etphli/ist-pico-project/cad/viewer/evidence/main-desktop-quarter.png

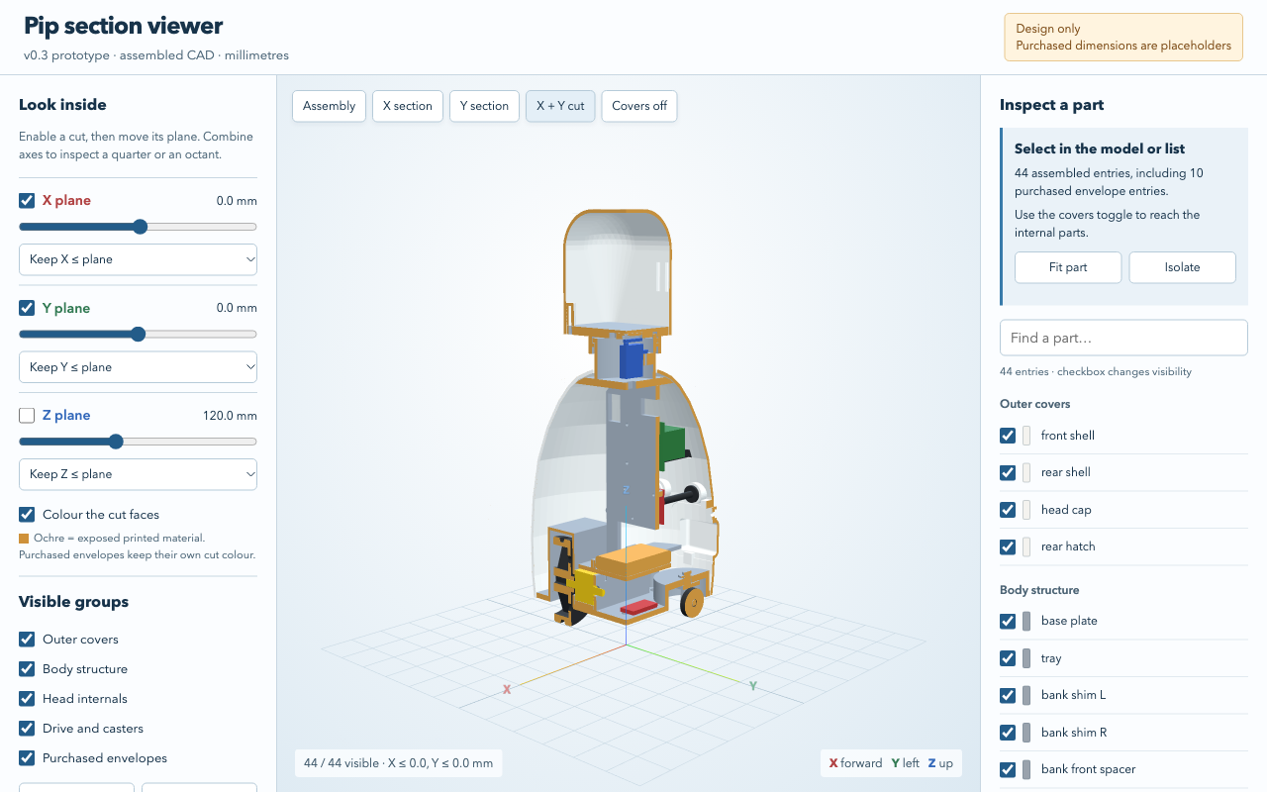
cad/viewer/evidence/main-desktop-quarter.png
