etphli/ist-pico-project/cad/viewer/evidence/main-mobile.png

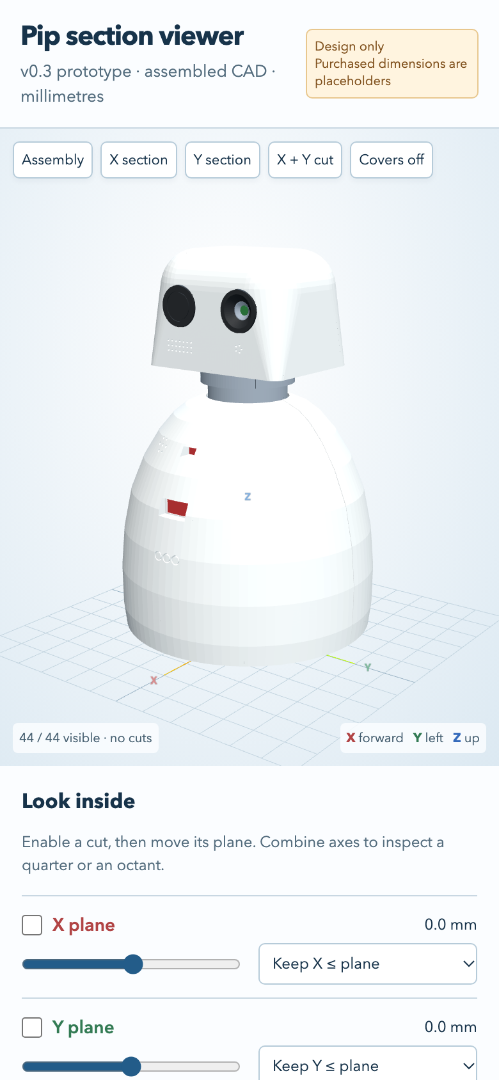
cad/viewer/evidence/main-mobile.png
