etphli/ist-pico-project/cad/viewer/evidence/quarter-cut.png

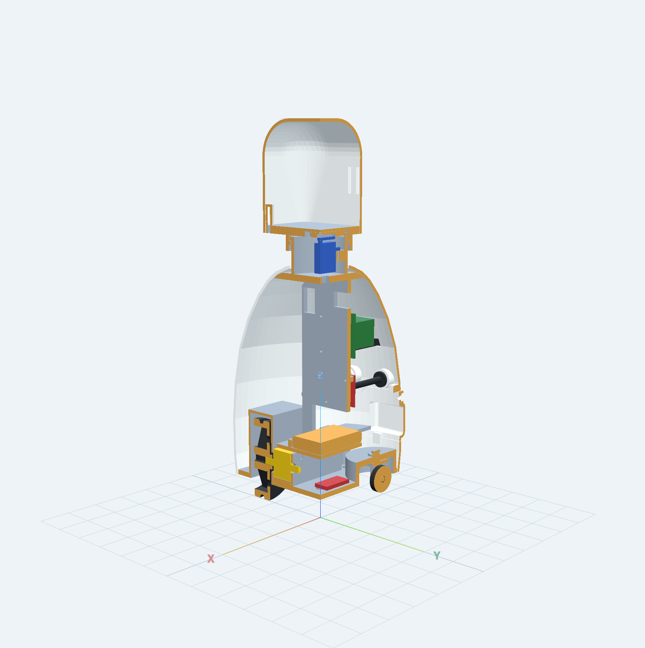
cad/viewer/evidence/quarter-cut.png
