etphli/ist-pico-project/docs/bom.csv

id | option | item | supplier | sku | qty | unit_aud_inc_gst | ext_aud_inc_gst | price_status | stock_2026-10-19 | role | requirement | solder_free_note | url
B1 | full;R1 | Kitronik Compact Motor Driver Board for Raspberry Pi Pico (5331; DRV8833) | Core Electronics | CE07855 | 1 | 19.95 | 19.95 | live product page 2026-10-19 | in stock (3 today; more 8-10 days) | 2-channel motor drive with stated short-circuit/over-current/thermal protection; on/off switch; powers Pico | F1 F2 F6 | Pico 2 WH plugs into socket; screw terminals | https://core-electronics.com.au/kitronik-motor-driver-board-for-raspberry-pi-pico.html
B2 | full;R1 | DC Gearbox TT Motor 200RPM 3-6V (200 mm 28 AWG leads with male pins) | Core Electronics | ADA3777 | 2 | 7.35 | 14.70 | live product page 2026-10-19 | in stock | drive wheels | F2 | leads pre-attached; pins clamp in screw terminals | https://core-electronics.com.au/dc-gearbox-motor-tt-motor-200rpm-3-to-6vdc.html
B3 | full;R1;R2 | Feetech FS90 9g micro servo 4.8-6V | Core Electronics | CE09376 | 1 | 5.70 | 5.70 | live product page 2026-10-19 | in stock | head pan | F3 | FS90 plug; rated compatible preterminated harness required (B20); actual pinout to verify | https://core-electronics.com.au/feetech-fs90-1-5kgcm-micro-servo-9g.html
B4 | full;R2 | DFRobot ESP32-S3 AI Camera Module DFR1154 (OV3660 160 deg; PDM mic; MAX98357 amp; MX1.25 speaker socket); manufacturer package includes speaker | Core Electronics | DFR1154 | 1 | 37.23 | 37.23 | live product page 2026-10-19; package list corrected 2026-10-21; confirm retailer bundle | in stock (16 today) | camera + mic + speaker amp in head | F5 F8 F9 | USB-C power; speaker plug-in | https://core-electronics.com.au/esp32-s3-ai-camera-module-edge-image-recognition-night-vision-voice-interaction.html
B5 | optional-spare | Mini Oval Speaker 8 ohm 1 W (Molex PicoBlade 1.25 mm 2-pin plug) | Core Electronics | ADA3923 | 0 | 4.80 | 0.00 | optional spare only; manufacturer DFR1154 package includes speaker; verify retailer bundle | OUT OF STOCK | not required when supplied speaker is present; previous duplicate purchase removed | F9 | plug-in if connector matches DFR1154 MX1.25 (to confirm) | https://core-electronics.com.au/mini-oval-speaker-8-ohm-1-watt.html
B6 | full;R1;R2 | PiicoDev Button | Core Electronics | CE08500 | 2 | 8.05 | 16.10 | live product page 2026-10-19 | in stock | rear button A wake + rear button B movement enable (I2C) | F6 | PiicoDev cable; A all ID OFF 0x42; B ID1 ON 0x09; power-cycle after setting | https://core-electronics.com.au/piicodev-button.html
B7 | full;R1 | PiicoDev Prototyping Cable (Male) 200mm | Core Electronics | CE07796 | 1 | 0.95 | 0.95 | live catalogue search 2026-10-19 | not shown | I2C chain from Kitronik GPIO terminals | F7 | SH-to-male breakout; terminal clamp fit and bus interface must be verified; not covered by owned SH-to-SH stock | https://core-electronics.com.au/piicodev-breakout-cable-200mm.html
B8 | full | USB-A male plug to 5-pin screw terminal block | Core Electronics | ADA3628 | 1 | 9.65 | 9.65 | live product page 2026-10-19 | in stock | bank port 1 -> body 5 V feed | F4 | no soldering (Core) | https://core-electronics.com.au/usb-a-male-plug-to-5-pin-terminal-block.html
B9 | full;R1 | Wago 221-413 3-conductor lever connector | Core Electronics | WG-221-413 | 2 | 1.40 | 2.80 | live catalogue search 2026-10-19 | in stock | +5 V / GND split to controller and servo | F4 | lever clamp (check wire gauge range on Wago data) | https://core-electronics.com.au/search/wago
B10 | full;R1 | Jumper Wire 10cm Ribbon M/M 40pcs | Core Electronics | CE09607 | 1 | 3.20 | 3.20 | live catalogue search 2026-10-19 | not shown | provisional signal wiring only; delete from order if B20 supplies signal lead | F3 | not approved for servo power or Wago termination without verified gauge and rating | https://core-electronics.com.au/search/jumper%20wire
B11 | full;R2 | USB-A to USB-C Cable 50cm 2A | Core Electronics | CE09370 | 1 | 3.25 | 3.25 | live product page 2026-10-19 | in stock | bank port 2 -> camera switch | F5 F15 | plug-in | https://core-electronics.com.au/50cm-usb-a-usb-c-cable.html
B12 | full;R2 | USB-C In-Line Power Switch Cable 28 cm (C female -> C male; power pins only; <=3 A) | Core Electronics | CE06575 | 1 | 3.45 | 3.45 | live product page 2026-10-19 | in stock | camera/mic hard-off | F15 | plug-in | https://core-electronics.com.au/micro-usb-c-in-line-power-switch-cable-for-raspberry-pi-4.html
B13 | full;R1;R2 | Delivery (Core standard) | Core Electronics | - | 1 |  |  | not quoted for this cart; example quote AU$6.25 to postcode 2000 for smaller carts | - | delivery | F11 | -
B14 | full | Stranded wire ~22 AWG red + black; measure W2-W5 routes | - | - | 1 |  |  | unpriced; no cheaper verified short pack found | - | 5 V feed ADA3628 -> lever connectors -> Kitronik; all W2-W5 lengths | F4 | 11 mm strip at Wago 221-413 ends; other terminal ends to their own marked requirement
B15 | full;R1;R2 | MINISO QW01 10000mAh power bank; approx 130x60x10mm; micro-USB input; two USB-A outputs each user-reported 5V 2A | - | QW01 | 1 | 0 | 0 | owned; user report 2026-10-20; combined output and fit unverified | owned | battery + accessible charge port | F4 | finished product
B16 | full;R1;R2 | Screws: 15 x M3 total (6 x M3x10; 5 x M3x8; 4 x M3x12); 4 x M2.5x6 | - | - | 1 |  |  | unpriced | - | frame/shell/head/board/button retention | N7 N10 | -
B17 | full;R1;R2 | 2 x hook-and-loop strap approx 12x250mm (bank); 2 x O-ring approx 60mm ID (tyres) | - | - | 1 |  |  | unpriced; maybe owned | - | retention; traction | F2 F4 | -
B18 | full;R1;R2 | FS90 mounting-tab and horn hardware; verify supplied screws and measure sizes | - | - | 1 |  |  | unpriced; sizes and supplied contents unverified |  | servo retention; additional to 15 x M3 fasteners | F3 N7 N10 | mechanical fasteners
B19 | full;R1 | PiicoDev direct-wiring interface and aggregate pull-up arrangement; solder-free implementation unselected | - | - | 1 |  |  | unpriced; unselected |  | sensor bus signal conditioning and cable-load review | F3 F7 | no soldering; verify compatibility
B20 | full;R1 | Rated preterminated FS90-compatible servo power harness; exact part unselected | - | - | 1 |  |  | unpriced; unselected |  | servo V+ and GND; may also provide GP27 signal lead | F3 F7 | no soldering; verify compatibility
O1 | full;R1;R2 | Standard PiicoDev SH-to-SH module cables; unlimited owned stock | - | - | 9 | 0.00 | 0.00 | owned; user confirmation 2026-10-21 |  | nine planned inter-module links C1-C9 | F7 | no soldering; verify compatibility
X1 | rejected | Makerverse Motor Driver 2 Channel | Core Electronics | CE08038 | 1 | 6.60 | 6.60 | live product page 2026-10-19 | in stock | rejected: terminals/headers need soldering (Core guide: unsoldered pads) | - | - | https://core-electronics.com.au/makerverse-motor-driver-2-channel.html
X2 | rejected | TT Motor 50RPM L-type (JST-PH) | Core Electronics | CE09390 | 2 | 2.50 | 5.00 | live product page 2026-10-19 | in stock | rejected: rated 3 V | - | - | https://core-electronics.com.au/tt-motor-l-type-50-rpm.html
X3 | rejected | Cytron Robo Pico | Core Electronics | CE11203 | 1 | 27.90 | 27.90 | live product page 2026-10-19 | OUT OF STOCK | rejected: out of stock; 1 A continuous < TT stall; no driver protection stated | - | - | https://core-electronics.com.au/robo-pico-simplifying-robotics-with-raspberry-pi-pico-pico-w.html
X4 | rejected | Battery Bank 5000mAh (one 5 V 2.1 A output) | Core Electronics | AD0505B | 1 | 26.95 | 26.95 | live product page 2026-10-19 | in stock | rejected for full concept: single output; price | - | - | https://core-electronics.com.au/battery-bank-5000mah.html
