etphli/ist-pico-project/cad/out/assembly_preview.stl

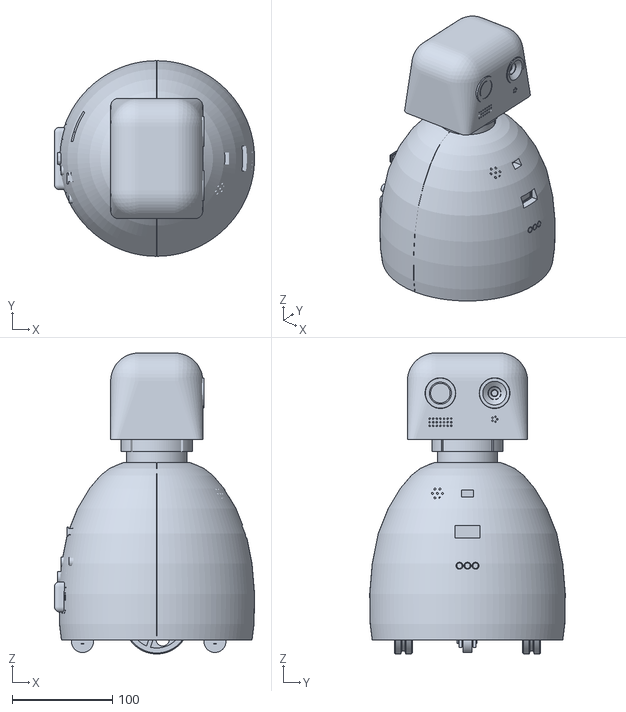
[picture p5: CAD file, 2026-10-21]
cad/out/assembly_preview.stl
199.5 x 195.0 x 300.0
