etphli/ist-pico-project/cad/out/stl/rear_hatch.stl

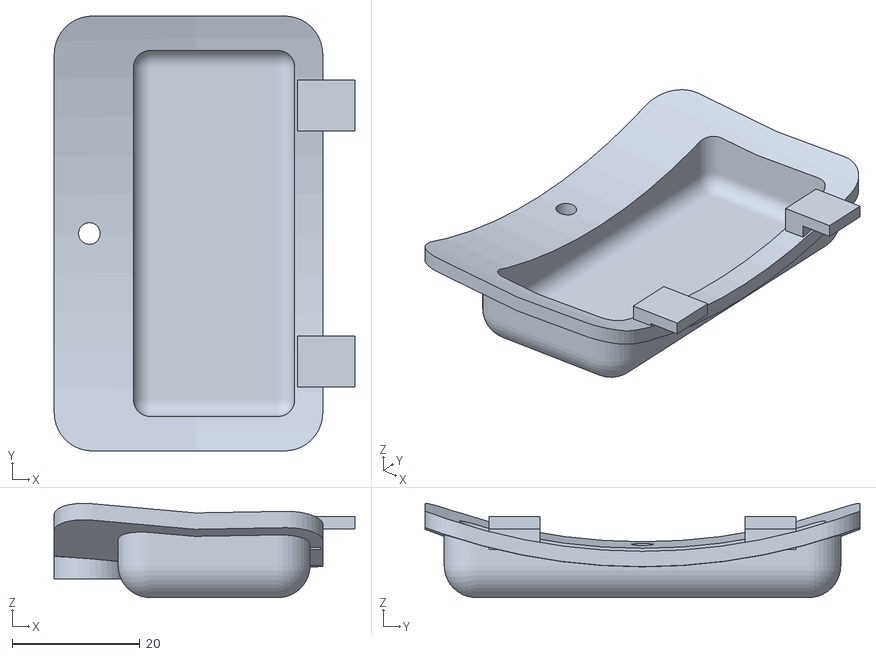
[picture p6: CAD file, 2026-10-21]
cad/out/stl/rear_hatch.stl
47.0 x 68.0 x 14.7
