etphli/ist-pico-project/cad/out/stl/base_plate.stl

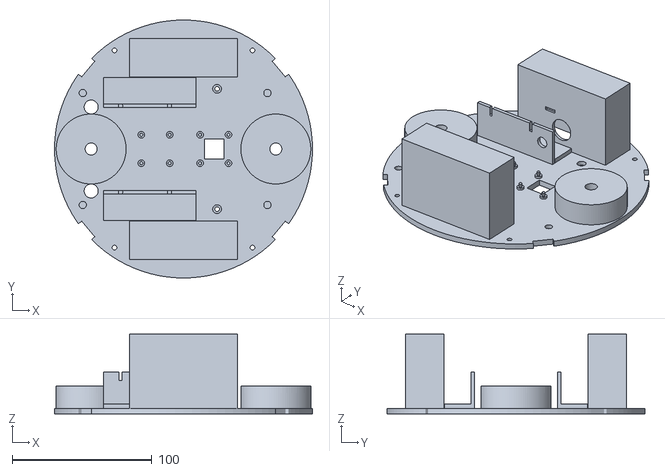
[picture p7: CAD file, 2026-10-21]
cad/out/stl/base_plate.stl
184.4 x 184.4 x 57.0
