etphli/ist-pico-project/cad/out/stl/bank_front_spacer.stl

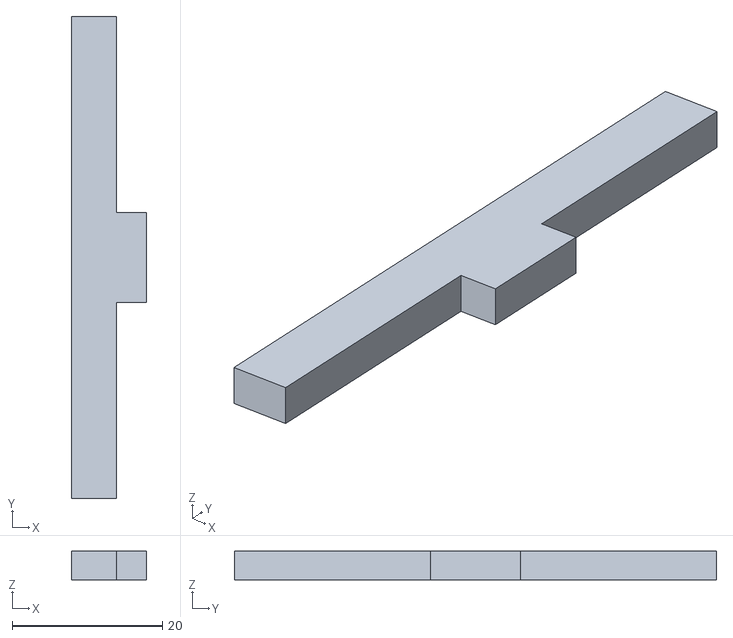
[picture p8: CAD file, 2026-10-21]
cad/out/stl/bank_front_spacer.stl
10.0 x 64.2 x 3.80
