etphli/ist-pico-project/cad/out/stl/column_L.stl

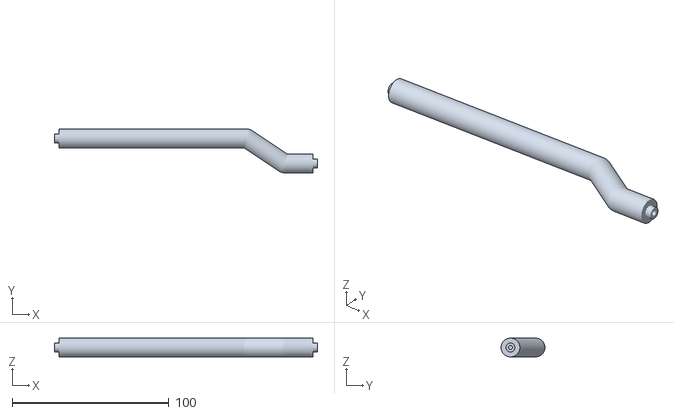
[picture p9: CAD file, 2026-10-21]
cad/out/stl/column_L.stl
167.8 x 28.0 x 12.0
