etphli/ist-pico-project/cad/out/stl/tray.stl

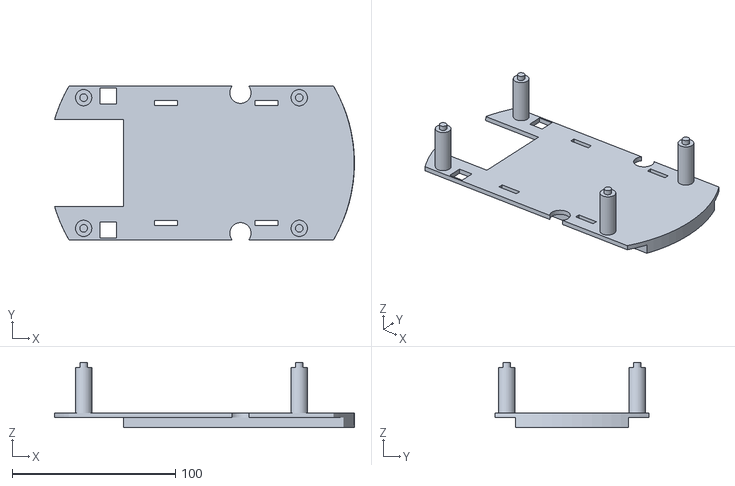
[picture p10: CAD file, 2026-10-21]
cad/out/stl/tray.stl
183.7 x 94.0 x 39.8
