etphli/ist-pico-project/cad/out/stl/bank_shim_R.stl

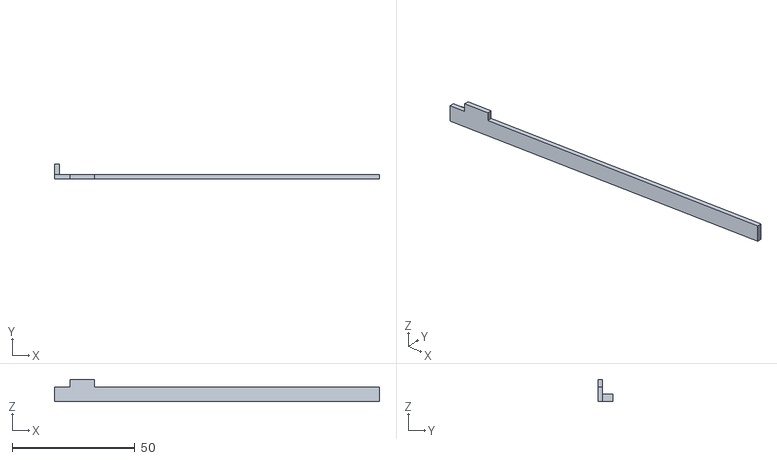
[picture p11: CAD file, 2026-10-21]
cad/out/stl/bank_shim_R.stl
132.3 x 6.10 x 9.00
