etphli/ist-pico-project/cad/out/stl/rear_shell.stl

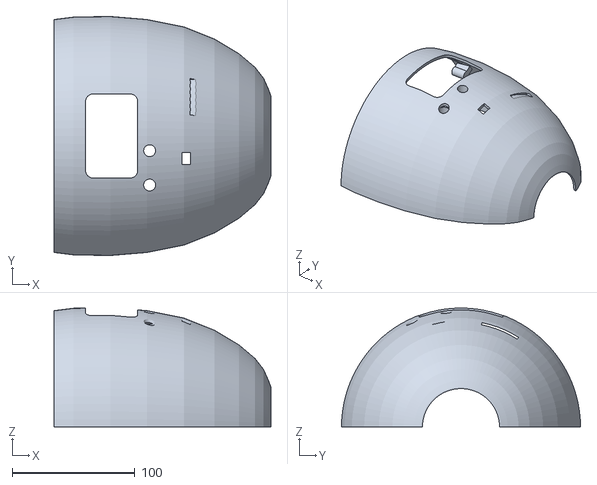
[picture p12: CAD file, 2026-10-21]
cad/out/stl/rear_shell.stl
177.0 x 195.0 x 97.0
