etphli/ist-pico-project/cad/out/stl/head_base.stl

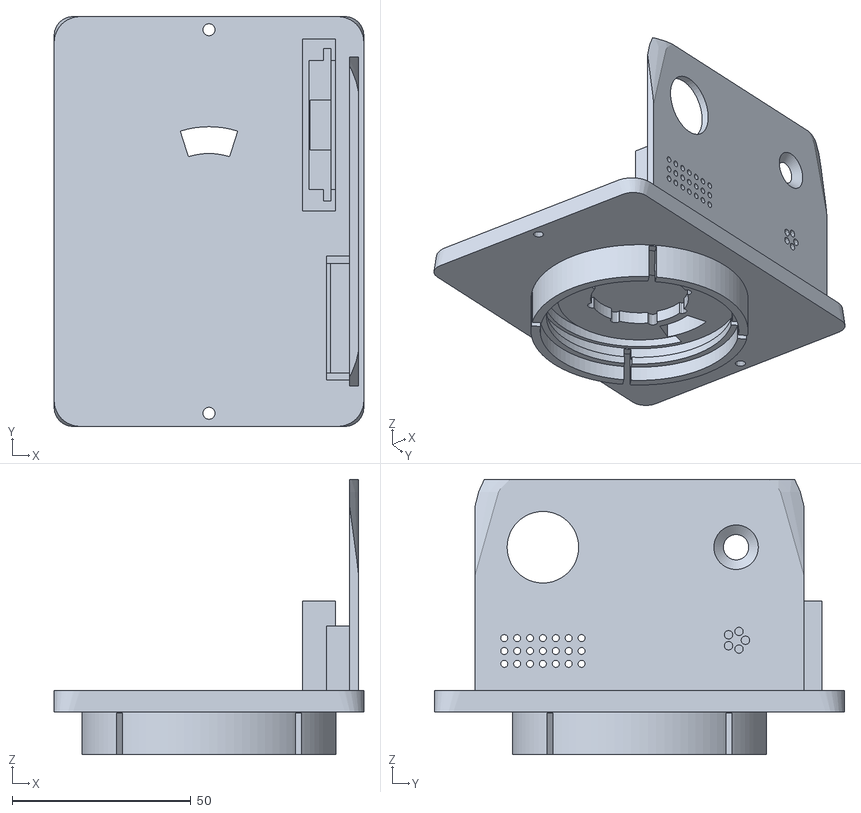
[picture p13: CAD file, 2026-10-19]
cad/out/stl/head_base.stl
86.6 x 114.6 x 77.0
