etphli/ist-pico-project/cad/out/stl/plunger_move.stl

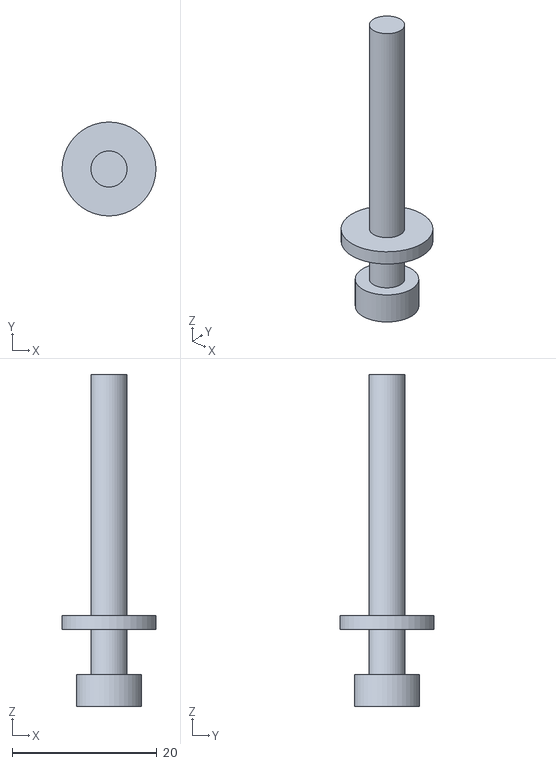
[picture p14: CAD file, 2026-10-19]
cad/out/stl/plunger_move.stl
13.0 x 13.0 x 45.9
