etphli/ist-pico-project/cad/out/stl/top_deck.stl

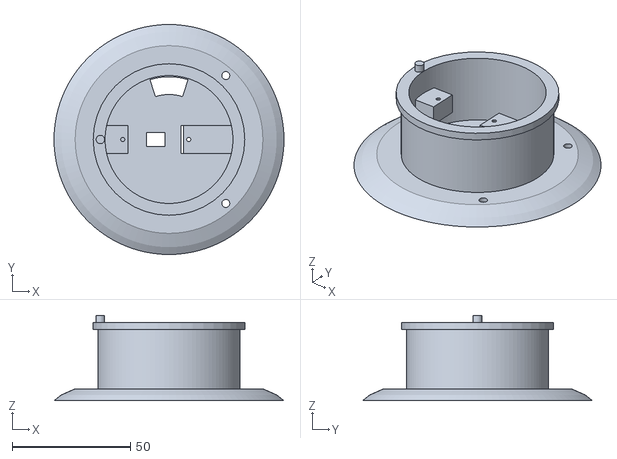
[picture p15: CAD file, 2026-10-19]
cad/out/stl/top_deck.stl
97.1 x 97.1 x 36.0
