etphli/ist-pico-project/cad/out/stl/rear_upright.stl

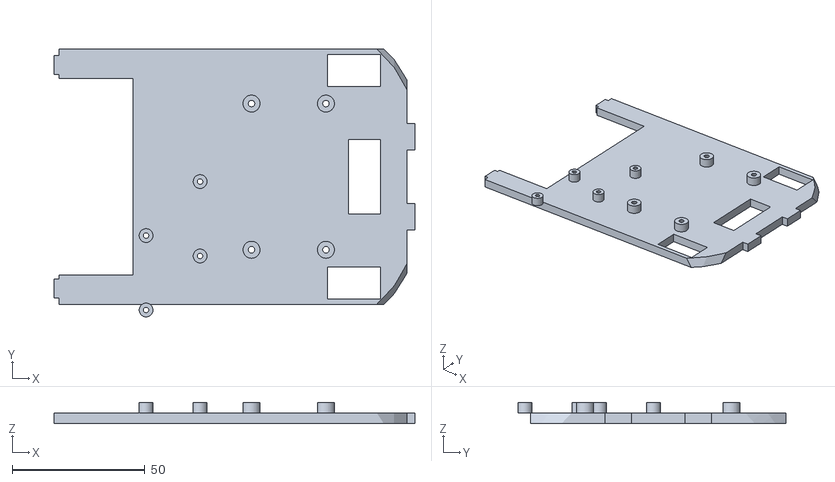
[picture p16: CAD file, 2026-10-19]
cad/out/stl/rear_upright.stl
135.8 x 100.8 x 8.00
