etphli/ist-pico-project/cad/out/stl/front_shell.stl

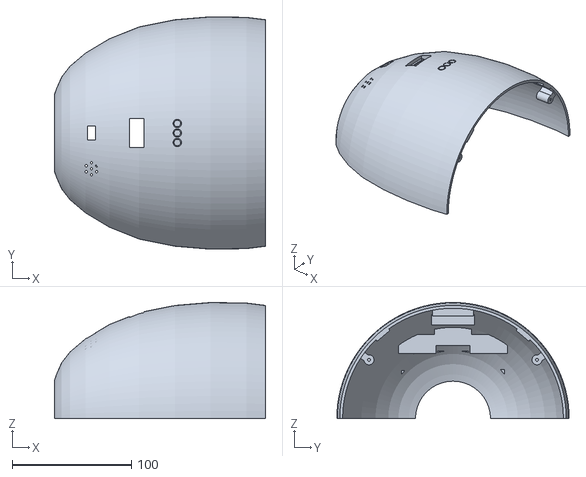
[picture p17: CAD file, 2026-10-19]
cad/out/stl/front_shell.stl
177.0 x 195.0 x 97.3
