etphli/ist-pico-project/cad/out/stl/eye_left_camera.stl

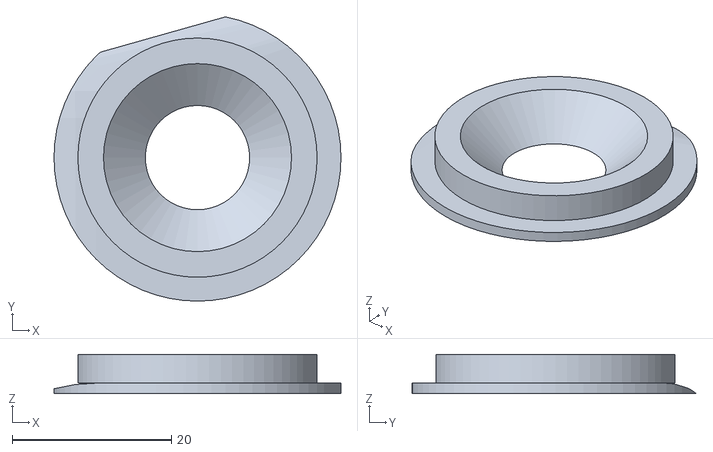
[picture p18: CAD file, 2026-10-19]
cad/out/stl/eye_left_camera.stl
36.0 x 35.7 x 4.90
