etphli/ist-pico-project/cad/out/stl/plunger_wake.stl

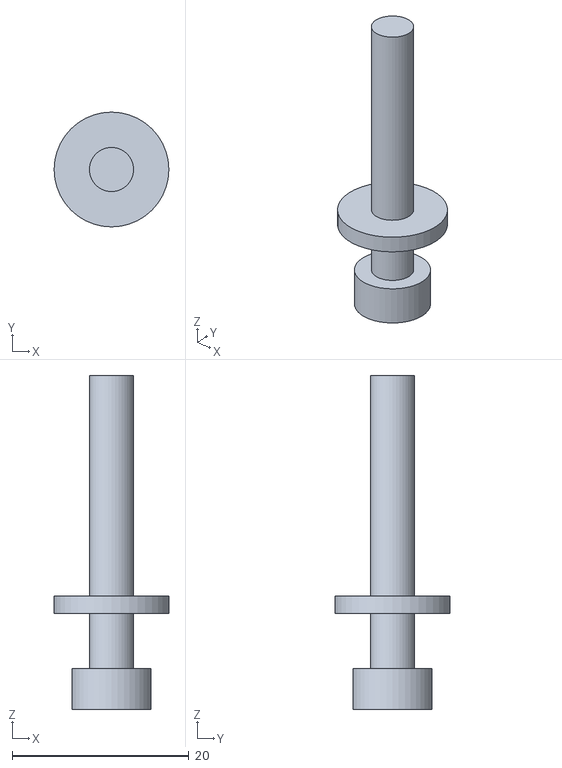
[picture p19: CAD file, 2026-10-19]
cad/out/stl/plunger_wake.stl
13.0 x 13.0 x 37.8
