etphli/ist-pico-project/cad/out/stl/switch_actuator.stl

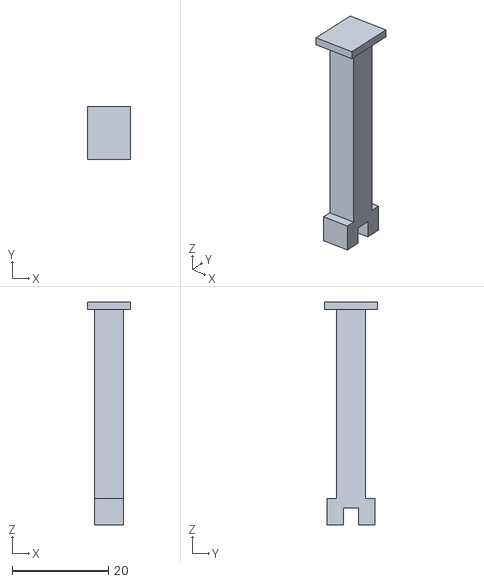
[picture p20: CAD file, 2026-10-19]
cad/out/stl/switch_actuator.stl
9.00 x 11.0 x 46.3
