etphli/ist-pico-project/cad/out/stl/eye_right.stl

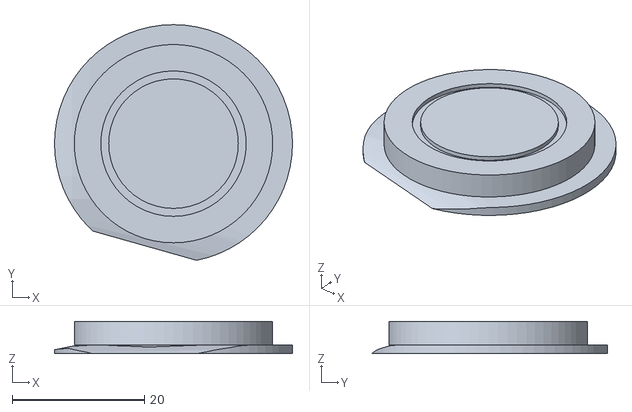
[picture p21: CAD file, 2026-10-19]
cad/out/stl/eye_right.stl
36.0 x 35.7 x 4.90
