etphli/ist-pico-project/cad/out/stl/head_cap.stl

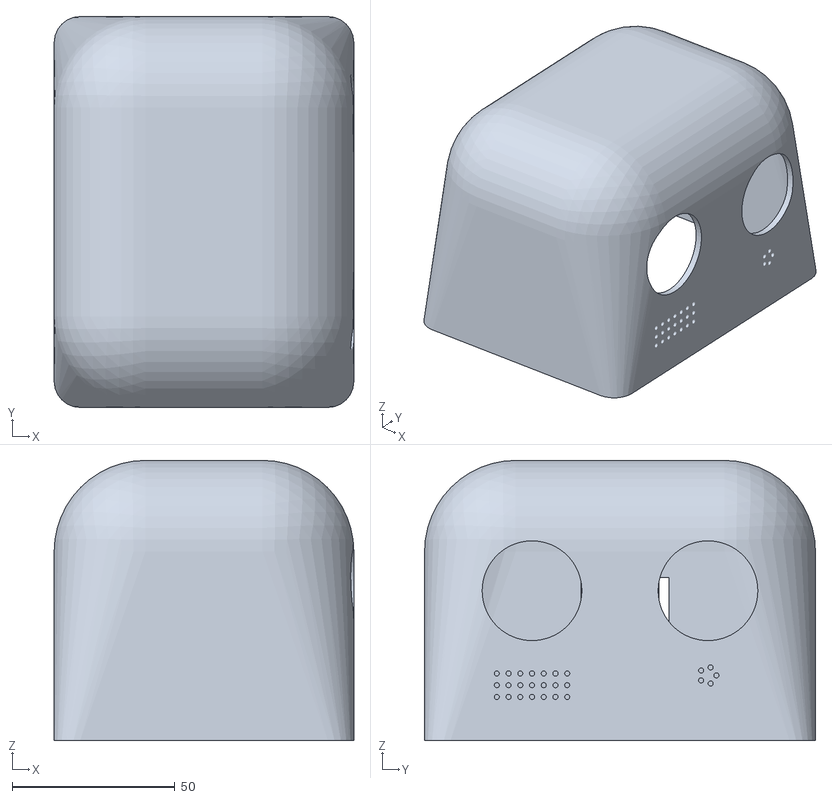
[picture p22: CAD file, 2026-10-19]
cad/out/stl/head_cap.stl
92.0 x 120.0 x 86.0
