etphli/ist-pico-project/cad/out/stl/drive_wheel_R.stl

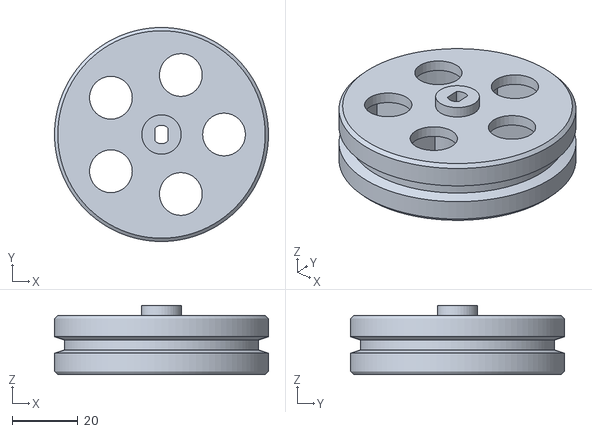
[picture p23: CAD file, 2026-10-19]
cad/out/stl/drive_wheel_R.stl
65.0 x 65.0 x 21.0
