etphli/ist-pico-project/cad/out/stl/fit_test_pegs.stl

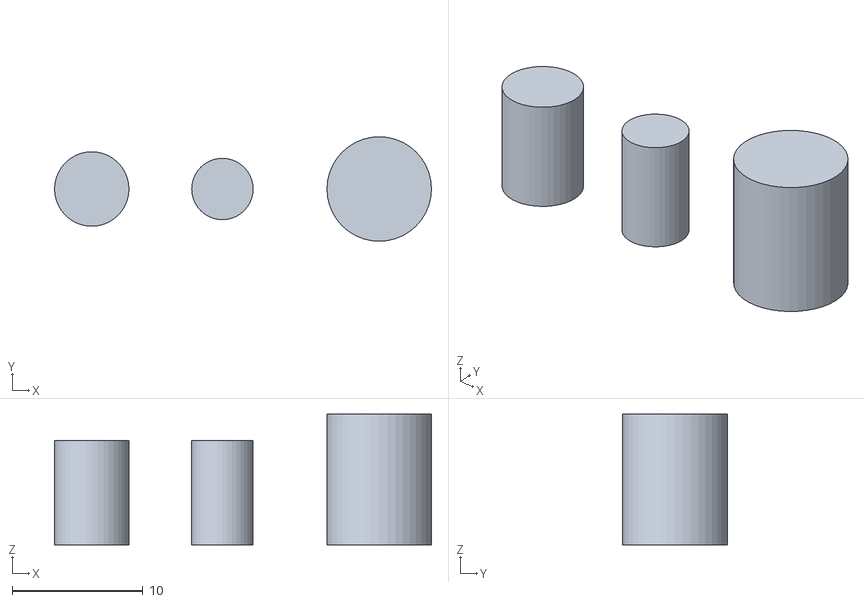
[picture p24: CAD file, 2026-10-19]
cad/out/stl/fit_test_pegs.stl
28.9 x 8.00 x 10.0
