etphli/ist-pico-project/cad/out/stl/caster_fork_F.stl

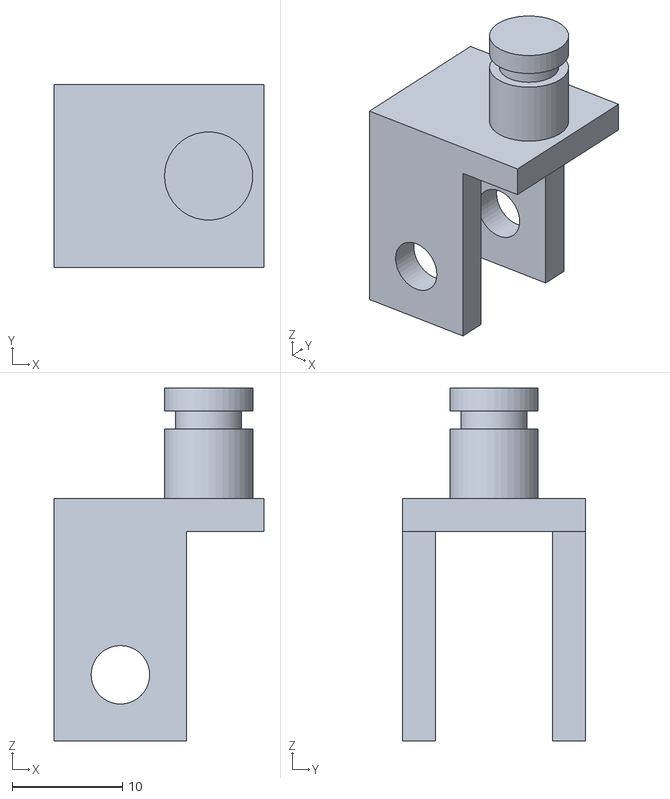
[picture p25: CAD file, 2026-10-19]
cad/out/stl/caster_fork_F.stl
19.0 x 16.6 x 32.0
