etphli/ist-pico-project/cad/out/stl/fit_test_coupon.stl

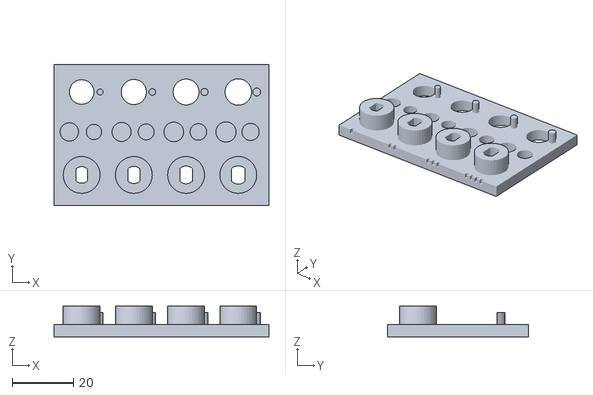
[picture p26: CAD file, 2026-10-19]
cad/out/stl/fit_test_coupon.stl
70.0 x 46.0 x 10.0
