etphli/ist-pico-project/cad/out/stl/clutch_disc.stl

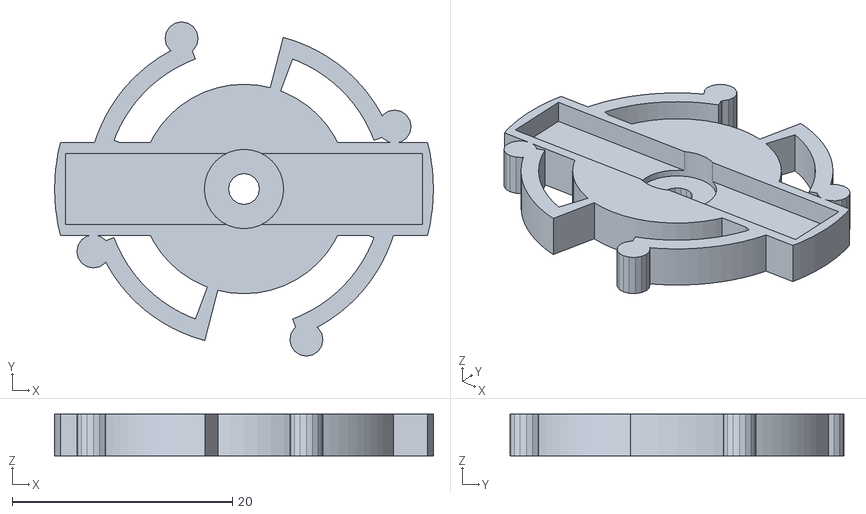
[picture p27: CAD file, 2026-10-19]
cad/out/stl/clutch_disc.stl
34.4 x 30.3 x 3.80
