etphli/ist-pico-project/cad/out/stl/caster_axle_F.stl

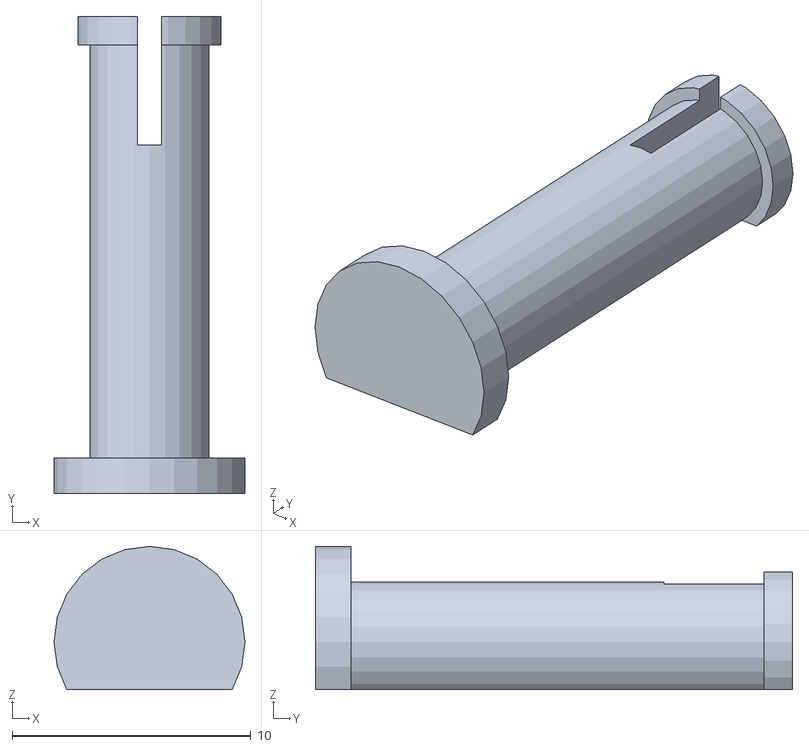
[picture p28: CAD file, 2026-10-19]
cad/out/stl/caster_axle_F.stl
8.00 x 20.0 x 6.00
