etphli/ist-pico-project/cad/out/stl/motor_strap.stl

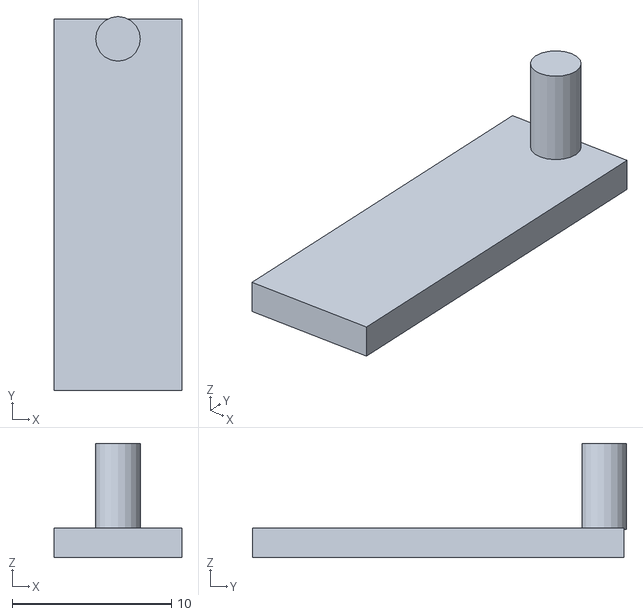
[picture p29: CAD file, 2026-10-19]
cad/out/stl/motor_strap.stl
8.00 x 23.5 x 7.15
