etphli/ist-pico-project/cad/out/stl/caster_wheel_F.stl

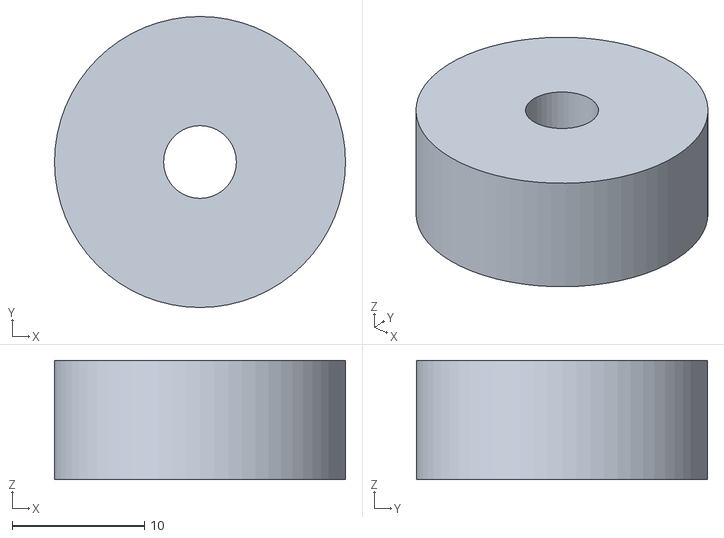
[picture p30: CAD file, 2026-10-19]
cad/out/stl/caster_wheel_F.stl
22.0 x 22.0 x 9.00
