etphli/ist-pico-project/cad/out/stl/caster_clip_F.stl

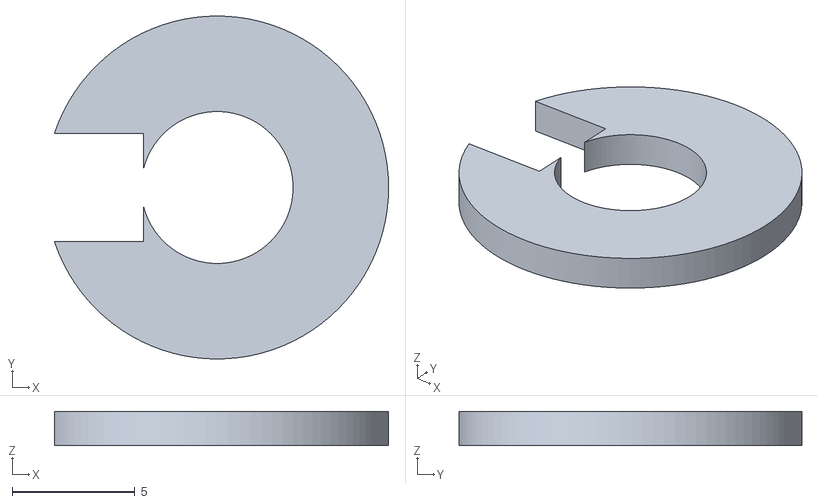
[picture p31: CAD file, 2026-10-19]
cad/out/stl/caster_clip_F.stl
13.6 x 14.0 x 1.40
