etphli/ist-pico-project/(list of files, cad)

Other CAD files:
cad/out/stl/bank_shim_L.stl
