etphli/ist-pico-project/cad/out/validation_report.md

# Pip CAD v0.3-prototype - automated validation report

Generated by `scripts/cad.sh` (cad/build.py). These are GEOMETRY checks on the parametric model with PLACEHOLDER dimensions for bought parts. They do not prove the real parts fit, print well, or are strong enough. See docs/12-measurement-calibration-checklist.md.

## 1. Part build and mesh validity

| part | kind | qty | status | manifold genus | volume cm3 | bbox (mm, assembly) | print bbox (mm) |
|---|---|---|---|---|---|---|---|
| fit_test_coupon | cal | 1 | NoError | 8 | 13.3 | 70 x 46 x 10 | 70 x 46 x 10 |
| fit_test_pegs | cal | 1 | NoError | -2 | 0.8 | 29 x 8 x 10 | 29 x 8 x 10 |
| base_plate | print | 1 | NoError | 15 | 175.5 | 184 x 184 x 57 | 184 x 184 x 57 |
| tray | print | 1 | NoError | 6 | 56.2 | 184 x 94 x 40 | 184 x 94 x 40 |
| bank_shim_L | print | 1 | NoError | 0 | 1.5 | 132 x 6 x 9 | 132 x 6 x 9 |
| bank_shim_R | print | 1 | NoError | 0 | 1.5 | 132 x 6 x 9 | 132 x 6 x 9 |
| bank_front_spacer | print | 1 | NoError | 0 | 1.6 | 4 x 64 x 10 | 10 x 64 x 4 |
| column_L | print | 2 | NoError | 0 | 18.8 | 12 x 28 x 168 | 168 x 28 x 12 |
| rear_upright | print | 1 | NoError | 11 | 39.2 | 8 x 101 x 136 | 136 x 101 x 8 |
| top_deck | print | 1 | NoError | 7 | 48.2 | 97 x 97 x 36 | 97 x 97 x 36 |
| front_shell | print | 1 | NoError | 9 | 145.9 | 97 x 195 x 177 | 177 x 195 x 97 |
| rear_shell | print | 1 | NoError | 6 | 118.1 | 97 x 195 x 177 | 177 x 195 x 97 |
| head_cap | print | 1 | NoError | 30 | 87.2 | 92 x 120 x 86 | 92 x 120 x 86 |
| head_base | print | 1 | NoError | 32 | 82.5 | 87 x 115 x 77 | 87 x 115 x 77 |
| clutch_disc | print | 1 | NoError | 3 | 1.5 | 34 x 30 x 4 | 34 x 30 x 4 |
| eye_left_camera | print | 1 | NoError | 1 | 2.4 | 5 x 36 x 36 | 36 x 36 x 5 |
| eye_right | print | 1 | NoError | 1 | 2.4 | 5 x 36 x 36 | 36 x 36 x 5 |
| drive_wheel_L | print | 1 | NoError | 6 | 30.0 | 65 x 21 x 65 | 65 x 65 x 21 |
| drive_wheel_R | print | 1 | NoError | 6 | 30.0 | 65 x 21 x 65 | 65 x 65 x 21 |
| motor_strap | print | 4 | NoError | 0 | 0.4 | 8 x 23 x 7 | 8 x 23 x 7 |
| caster_fork_F | print | 2 | NoError | 2 | 2.6 | 19 x 17 x 32 | 19 x 17 x 32 |
| caster_wheel_F | print | 2 | NoError | 1 | 3.2 | 22 x 9 x 22 | 22 x 22 x 9 |
| caster_axle_F | print | 2 | NoError | 0 | 0.4 | 8 x 20 x 6 | 8 x 20 x 6 |
| caster_clip_F | print | 2 | NoError | 0 | 0.1 | 14 x 14 x 1 | 14 x 14 x 1 |
| plunger_wake | print | 1 | NoError | 0 | 1.2 | 38 x 13 x 13 | 13 x 13 x 38 |
| plunger_move | print | 1 | NoError | 0 | 1.3 | 46 x 13 x 13 | 13 x 13 x 46 |
| rear_hatch | print | 1 | NoError | 1 | 9.8 | 15 x 68 x 47 | 47 x 68 x 15 |
| switch_actuator | print | 1 | NoError | 0 | 1.8 | 46 x 11 x 9 | 9 x 11 x 46 |
| column_R | inst | 1 | NoError | 0 | 18.8 | 12 x 28 x 168 |  |
| caster_fork_R | inst | 1 | NoError | 2 | 2.6 | 19 x 17 x 32 |  |
| caster_wheel_R | inst | 1 | NoError | 1 | 3.2 | 22 x 9 x 22 |  |
| caster_axle_R | inst | 1 | NoError | 0 | 0.4 | 8 x 20 x 6 |  |
| caster_clip_R | inst | 1 | NoError | 0 | 0.1 | 14 x 14 x 1 |  |
| motor_strap_2 | inst | 1 | NoError | 0 | 0.4 | 8 x 23 x 7 |  |
| motor_strap_3 | inst | 1 | NoError | 0 | 0.4 | 8 x 23 x 7 |  |
| motor_strap_4 | inst | 1 | NoError | 0 | 0.4 | 8 x 23 x 7 |  |
| ref_power_bank | ref | 1 | NoError | 0 | 76.5 | 130 x 60 x 10 |  |
| ref_tt_motor_L | ref | 1 | NoError | 0 | 30.0 | 70 x 37 x 22 |  |
| ref_tt_motor_R | ref | 1 | NoError | 0 | 30.0 | 70 x 37 x 22 |  |
| ref_controller | ref | 1 | NoError | 0 | 27.1 | 24 x 63 x 35 |  |
| ref_buttons | ref | 1 | NoError | -1 | 4.0 | 11 x 53 x 25 |  |
| ref_servo | ref | 1 | NoError | -1 | 6.8 | 38 x 12 x 26 |  |
| ref_cam_board | ref | 1 | NoError | 0 | 7.9 | 11 x 42 x 42 |  |
| ref_head_speaker | ref | 1 | NoError | 0 | 3.0 | 5 x 30 x 20 |  |
| ref_front_modules | ref | 1 | NoError | -4 | 14.5 | 55 x 85 x 93 |  |
| ref_base_modules | ref | 1 | NoError | -1 | 3.9 | 67 x 25 x 3 |  |

## 1b. Exported STL re-check (trimesh, independent of manifold3d)

| file | triangles | watertight | winding consistent | volume cm3 |
|---|---|---|---|---|
| bank_front_spacer.stl | 28 | True | True | 1.6 |
| bank_shim_L.stl | 46 | True | True | 1.5 |
| bank_shim_R.stl | 46 | True | True | 1.5 |
| base_plate.stl | 10274 | True | True | 175.5 |
| caster_axle_F.stl | 248 | True | True | 0.4 |
| caster_clip_F.stl | 724 | True | True | 0.1 |
| caster_fork_F.stl | 1080 | True | True | 2.6 |
| caster_wheel_F.stl | 416 | True | True | 3.2 |
| clutch_disc.stl | 1496 | True | True | 1.5 |
| column_L.stl | 980 | True | True | 18.8 |
| drive_wheel_L.stl | 3210 | True | True | 30.0 |
| drive_wheel_R.stl | 3210 | True | True | 30.0 |
| eye_left_camera.stl | 718 | True | True | 2.4 |
| eye_right.stl | 1154 | True | True | 2.4 |
| fit_test_coupon.stl | 3324 | True | True | 13.3 |
| fit_test_pegs.stl | 468 | True | True | 0.8 |
| front_shell.stl | 4704 | True | True | 145.9 |
| head_base.stl | 5032 | True | True | 82.5 |
| head_cap.stl | 3950 | True | True | 87.2 |
| motor_strap.stl | 100 | True | True | 0.4 |
| plunger_move.stl | 636 | True | True | 1.3 |
| plunger_wake.stl | 636 | True | True | 1.2 |
| rear_hatch.stl | 2002 | True | True | 9.8 |
| rear_shell.stl | 4112 | True | True | 118.1 |
| rear_upright.stl | 2044 | True | True | 39.2 |
| switch_actuator.stl | 70 | True | True | 1.8 |
| top_deck.stl | 2818 | True | True | 48.2 |
| tray.stl | 1852 | True | True | 56.2 |

## 1c. Printer bed fit (bounding box only; 90 degree turn on the bed allowed)

| part | 220x220x250 (Ender-3 class) | 256x256x256 (Bambu P1/X1 class) | 180x180x180 (A1 mini class) |
|---|---|---|---|
| fit_test_coupon | fits | fits | fits |
| fit_test_pegs | fits | fits | fits |
| base_plate | fits | fits | **no** |
| tray | fits | fits | **no** |
| bank_shim_L | fits | fits | fits |
| bank_shim_R | fits | fits | fits |
| bank_front_spacer | fits | fits | fits |
| column_L | fits | fits | fits |
| rear_upright | fits | fits | fits |
| top_deck | fits | fits | fits |
| front_shell | fits | fits | **no** |
| rear_shell | fits | fits | **no** |
| head_cap | fits | fits | fits |
| head_base | fits | fits | fits |
| clutch_disc | fits | fits | fits |
| eye_left_camera | fits | fits | fits |
| eye_right | fits | fits | fits |
| drive_wheel_L | fits | fits | fits |
| drive_wheel_R | fits | fits | fits |
| motor_strap | fits | fits | fits |
| caster_fork_F | fits | fits | fits |
| caster_wheel_F | fits | fits | fits |
| caster_axle_F | fits | fits | fits |
| caster_clip_F | fits | fits | fits |
| plunger_wake | fits | fits | fits |
| plunger_move | fits | fits | fits |
| rear_hatch | fits | fits | fits |
| switch_actuator | fits | fits | fits |

A bounding-box fit does not mean the part prints well; no slicer was run.

## 2. Interference check (all part pairs, assembled position)

Unexpected overlap > 1 mm3 between parts that should not touch is listed as a problem. Expected contacts (pegs in sockets, captured parts) are listed separately.

No unexpected interference above the configured threshold found. Excluded contact pairs still require fit review.

Excluded (expected-contact) pairs that DO overlap, with the reason each is allowed. An exclusion only means the overlap is not reported as a problem; it does not prove the fit. Each one is a physical check in docs/12.

| pair | overlap mm3 | why it is excluded |
|---|---|---|
| `base_plate` x `ref_base_modules` | 81.0 | modules on peg posts |
| `head_base` x `clutch_disc` | 69.2 | disc in pocket |
| `drive_wheel_L` x `ref_tt_motor_L` | 28.5 | shaft in wheel bore |
| `drive_wheel_R` x `ref_tt_motor_R` | 28.5 | shaft in wheel bore |

## 3. Selected clearances (min gap, mm; search radius 10 mm)

| pair | why | min gap |
|---|---|---|
| drive_wheel_L / base_plate | tyre vs guard well / plate slot | 1.70 |
| drive_wheel_R / base_plate | tyre vs guard well / plate slot | 1.70 |
| caster_fork_F / base_plate | caster swivel sweep (only one angle checked) | 0.30 |
| caster_wheel_F / base_plate | caster wheel vs tower | 1.55 |
| head_base / top_deck | rotating head skirt vs fixed neck | 0.38 |
| head_cap / front_shell | head vs body shoulder | 10.00 |
| head_cap / rear_shell | head vs body shoulder | 10.00 |
| ref_power_bank / tray | nominal bank in cradle (sits on the floor: 0) | 0.00 |
| ref_power_bank / bank_shim_L | nominal bank vs side shim (~0.3) | 0.30 |
| ref_power_bank / bank_front_spacer | nominal bank vs front spacer (~0.3) | 0.30 |
| ref_power_bank / column_L | bank beside the jogged column | 7.00 |
| rear_hatch / rear_shell | hatch in its opening (~0.3) | 0.28 |
| rear_hatch / tray | hatch tongues vs tray | 1.20 |
| ref_controller / rear_shell | controller + Pico vs shell | 7.66 |
| ref_buttons / plunger_wake | button cap vs plunger tip (should be ~0.3) | 0.30 |
| ref_buttons / plunger_move | button cap vs plunger tip (should be ~0.3) | 0.30 |
| ref_tt_motor_L / base_plate | motor in cradle | 0.20 |
| ref_servo / top_deck | servo in neck | 0.00 |
| ref_cam_board / head_cap | camera board vs head cap | 1.24 |
| ref_cam_board / eye_left_camera | lens vs eye insert | 4.83 |
| eye_left_camera / head_base | eye flange vs eye frame (should be ~0.3) | 0.30 |
| eye_right / head_base | eye flange vs eye frame (should be ~0.3) | 0.30 |
| clutch_disc / head_base | clutch in pocket | 0.00 |

## 3b. Sampled motion checks (not a continuous collision proof)

- front caster swivel 0-355 deg (5 deg samples) vs base_plate: max overlap 0.0 mm3 -> OK
- rear caster swivel 0-355 deg (5 deg samples) vs base_plate: max overlap 0.0 mm3 -> OK
- head pan -75..+75 deg (31 samples, 5 deg apart) vs top_deck: worst overlap 0.7 mm3 at +75 deg
- head pan -75..+75 deg (31 samples, 5 deg apart) vs front_shell: worst overlap 0.0 mm3
- head pan -75..+75 deg (31 samples, 5 deg apart) vs rear_shell: worst overlap 0.0 mm3
- Samples only: a collision narrower than 5 deg of travel could be missed. The stop pin meeting the groove end at +/-75 deg is a designed contact and is not modelled as a motion.

## 3c. Camera field-of-view cone (design FOV, geometric only)

Cone from the lens front (placeholder lens position) with a 90 deg full angle, out to just past the eye face. The lens itself is rated 160 deg by DFRobot; everything outside the design cone is deliberately vignetted by the eye.

- FOV cone vs eye_left_camera: 0.000 mm3 -> clear
- FOV cone vs head_cap: 0.000 mm3 -> clear
- FOV cone vs head_base: 0.000 mm3 -> clear
- FOV cone vs clutch_disc: 0.000 mm3 -> clear
- FOV cone vs ref_head_speaker: 0.000 mm3 -> clear
- Not checked: the lens's real position on the board, image distortion, glare or IR reflection from the eye bore. Measure the lens position (docs/12 E8).

## 3d. Bank-fit regression (MINISO QW01, approximate size)

Nominal **130 x 60 x 10 mm is the user's approximate size, not a measurement.** The cradle is built for any bank in L 126-134, W 56-64, T 8-16 mm (fixed cavity ranges; nominal size changes only the fillers). Port end on the plane x = -47.5. Port centres assumed within |y| <= 16 and >= 3 mm inside the top/bottom faces, all on the rear end (NOT confirmed). Plug sweep depth 48 mm (largest of: ADA3628 protrusion + wire bend, USB-A->C overmould + bend, micro-USB + bend; all MEASURE).

| keep-out | meaning | result |
|---|---|---|
| K1 largest bank | 134 x 64 x 16 sharp-cornered box vs every part and envelope | clear |
| K2 plug sweep | 51 W x 21.4 H x 48 deep behind the port plane, incl. hatch and shims | clear |
| K3 open end face | whole end face of the largest bank, 25 mm deep (only the removable keepers may enter) | clear |
| K4 access path | straight reach from outside to the port sweep, hatch removed | clear |
| K5 lead route | output leads up the +Y side behind the upright to controller height | clear |
| K6 strap path | 2 hook-and-loop straps: slots and under-tray band | clear |

- Removable rear corner keepers inside the end face: 98.5 mm3 total (each 4 mm in from the side, 3 mm high; outside the port sweep: yes). Trim them if a port is nearer the edge than assumed.
- Largest bank to rails 0.30 mm per side, to the front wall 0.30 mm (grown envelope vs tray: 0.00 mm3 -> OK). Rails 6 mm high, below the thinnest bank (8 mm), so the straps bear on the bank, not the rails.
- Floor under the nominal bank footprint (130 x 60): 100.0% solid
- Floor under the largest bank footprint (134 x 64): 100.0% solid
- Floor under the smallest bank footprint (126 x 56): 100.0% solid
- Nominal bank with the default fillers: shim 1.8 mm, front spacer 3.8 mm; gap to bank_shim_L 0.30 mm (overlap 0.0 mm3), gap to bank_shim_R 0.30 mm (overlap 0.0 mm3), gap to bank_front_spacer 0.30 mm (overlap 0.0 mm3), gap to tray 0.00 mm (overlap 0.0 mm3)
- After measuring: shim = 31.8 - W/2 mm, spacer = 133.8 - L mm. A bank outside the band needs new rails, not thinner fillers.
- Rear hatch to rear shell: 0.28 mm min gap; hatch pod to the plug sweep: 1.90 mm
- Regression: QW01 at the v0.2 position vs the v0.2 straight columns: 1813.6 mm3 (detected, as it should be); largest bank vs the v0.3 columns: 0.0 mm3.
- Bank mass: **unmeasured**. It is left out of the stability estimate (section 4); weigh it (docs/12 E1).
- Not checked: the real bank size, rounding, port positions or which end the micro-USB input is on; real plug and lead sizes; strap tension; whether the bank can slide under shock.

## 4. Static stability ESTIMATE

- Printed plastic (PLA, 55% effective fill): ~607 g
- Estimated total mass WITHOUT the power bank: ~808 g (component masses below are partly guesses)
- The QW01 mass is unmeasured, so it is NOT included. Its nominal centroid is at x=18 y=-0 z=54 mm, lower than the no-bank CG below; adding it would lower the CG and move it forward by an amount that depends on the real mass. No tip angle with the bank is claimed.
- Estimated CG without the bank: x=-0.5 y=0.3 z=111.6 mm
- Static tip angle without the bank, sideways (over a drive wheel): ~30 deg
- Static tip angle without the bank, forward/back (over a caster, worst trail orientation): ~28 / 27 deg
- Physical test required: tilt-table test with the real build (docs/09).

| component | mass g | source |
|---|---|---|
| power_bank | **unmeasured** | UNMEASURED (QW01) - excluded; weigh it |
| tt_motor_L | 31 | Core ADA3777 listing |
| tt_motor_R | 31 | Core ADA3777 listing |
| fs90_servo | 9 | estimate (9 g class) |
| controller_with_pico | 35 | estimate |
| piicodev_buttons_x2 | 10 | estimate |
| camera_board | 20 | estimate |
| head_speaker | 1 | ADA3923 listing |
| piicodev_modules_x6 | 24 | estimate |
| cables | 40 | estimate |

## 5. What these checks do NOT establish

- Real fit: every bought-part envelope and mounting position is a placeholder (`# MEASURE`). The QW01 size is the user's approximate estimate; section 3d checks accommodation envelopes, not the real bank.
- Excluded contact pairs (section 2) are not proven to fit. They are listed with their overlap volume for review.
- Continuous motion clearance: caster and head checks are discrete samples (section 3b).
- Cable routing, bend radius and cable twist through the neck.
- Fastener engagement and strength: screw holes are modelled, thread engagement and pull-out are not.
- Printability (no slicer run), strength (no FEA), toy-standard compliance.
- The camera's real field of view, focus and image quality (section 3c is geometry only).

## 6. Summary

All automated geometry checks passed (this does NOT mean the design is verified on real parts).

Build time 1 s. Placeholder dimensions are marked `# MEASURE` in cad/pip_robot/params.py.
