etphli/ist-pico-project/cad/pip_robot/parts.py

"""Pip companion robot - CAD v0.3 part geometry.

Every function returns a manifold3d.Manifold positioned in ASSEMBLY coordinates
(see params.py). build.py re-orients printable parts for export.

This is a PROVISIONAL prototype model. Positions of buttons, switches, ports,
mounting holes etc. on bought modules are placeholders (`# MEASURE` in params).
"""

import math
from dataclasses import dataclass

from manifold3d import CrossSection, Manifold

from .params import P
from .prims import (box, cyl_x, cyl_y, cyl_z, interp_profile, polar, ring_sector,
                    rounded_box, solid_of_profile, tube_z, union)

pr, B, D, C, BAT, BD, N, H, F = P.pr, P.body, P.drive, P.caster, P.bat, P.boards, P.neck, P.head, P.front
HT = P.hatch


# --------------------------------------------------------------------------- derived
@dataclass(frozen=True)
class Derived:
    plate_top: float = B.base_z + B.base_t
    plate_r: float = interp_profile(B.profile, B.base_z) - pr.shell - 0.4
    axle_z: float = D.wheel_d / 2
    wheel_yc: float = D.track / 2
    wheel_in: float = D.track / 2 - D.wheel_w / 2
    wheel_out: float = D.track / 2 + D.wheel_w / 2
    motor_out_y: float = D.track / 2 - D.wheel_w / 2 - D.hub_gap
    motor_in_y: float = D.track / 2 - D.wheel_w / 2 - D.hub_gap - D.tt_t
    motor_z0: float = D.wheel_d / 2 - D.tt_h / 2
    motor_z1: float = D.wheel_d / 2 + D.tt_h / 2
    motor_x1: float = D.tt_shaft_from_end
    motor_x0: float = D.tt_shaft_from_end - D.tt_len
    tray_top: float = B.tray_z + B.tray_t
    deck_top: float = B.top_deck_z + B.top_deck_t
    neck_top: float = B.top_deck_z + B.top_deck_t + N.h
    head_floor_z: float = B.top_deck_z + B.top_deck_t + N.h + H.gap_above_neck
    column_xy: tuple = ((24.0, 27.0), (24.0, -27.0))     # column UPPER axis (deck sockets, unchanged from v0.2)
    upright_x: tuple = (-34.0, -30.0)


DV = Derived()
WELL_IN_Y0 = DV.motor_out_y + 0.3              # guard wall between motor and wheel
WELL_IN_Y1 = WELL_IN_Y0 + D.wheel_well_wall
WELL_OUT_Y0 = DV.wheel_out + D.wheel_well_gap
WELL_X = D.wheel_d / 2 + D.wheel_well_gap
WELL_TOP = D.wheel_d + D.wheel_well_gap
CASTER_HOLE_R = C.trail + C.wheel_d / 2 + 2.0
CASTER_ROOF_Z = C.lift + C.wheel_d + 2.0 + C.fork_t + 0.5      # underside of tower roof
TRAY_LEGS = ((60.0, 40.0), (60.0, -40.0), (-72.0, 40.0), (-72.0, -40.0))   # v0.3: moved clear of the bank
# v0.3 front columns: the 130 mm bank runs under them, so the LOWER axis moves outboard to
# |y| = 43 and each column jogs back in to the unchanged deck sockets above the bank.
COLUMN_LOW = ((24.0, 43.0), (24.0, -43.0))
COLUMN_JOG_Z = (138.0, 162.0)
COLUMN_R = 6.0

# --------------------------------------------------------------------------- power bank (QW01)
# Every bank number below derives from the APPROXIMATE user size plus the accommodation band in
# params.Battery. The cradle is sized for the largest accommodated bank; printed shims, a front
# spacer and two corner keepers take up the difference for the bank actually measured.
BANK_L_MAX = BAT.len_range[1]
BANK_W_MAX = BAT.w_range[1]
BANK_T_MAX = BAT.t_range[1]
BANK_L_MIN = BAT.len_range[0]
BANK_W_MIN = BAT.w_range[0]
BANK_T_MIN = BAT.t_range[0]
CAV_HW = BANK_W_MAX / 2 + BAT.fit_gap                 # side-rail inner face |y|
CAV_X1 = BAT.port_x + BANK_L_MAX + BAT.fit_gap        # front-wall inner face
SPACER_X = (BAT.port_x + BAT.len_nom + BAT.fit_gap, CAV_X1 - 0.2)    # front spacer for len_nom
SHIM_Y = (BAT.w_nom / 2 + BAT.fit_gap, CAV_HW - 0.2)                  # side shim for w_nom
_PLUGS = (BAT.plug_out1, BAT.plug_out2, BAT.plug_charge)
PLUG_LEN = max(p[0] + p[3] for p in _PLUGS)           # straight plug + cable bend, behind the port face
SWEEP_Y = BAT.port_y_max + max(p[1] for p in _PLUGS) / 2
SWEEP_Z = (B.tray_z + B.tray_t + BAT.port_edge_z - max(p[2] for p in _PLUGS) / 2,
           B.tray_z + B.tray_t + BANK_T_MAX - BAT.port_edge_z + max(p[2] for p in _PLUGS) / 2)
STRAP_SLOT_Y = (CAV_HW + BAT.rail_t + 0.5, CAV_HW + BAT.rail_t + 3.7)
SHELL_RIB_ANGLES = (40.0, -40.0, 140.0, -140.0)
# Shells are screwed from UNDER the base plate (adult, tool needed) into bosses inside the
# shell rim. The v0.1 roof screws sat under the head and could not be reached.
SHELL_SCREW_R = 86.0
SHELL_SCREW_ANG_FRONT = (55.0, -55.0)
SHELL_SCREW_ANG_REAR = (125.0, -125.0)
M3_PILOT_R = 1.25            # thread-forming M3 into PLA (tune with the fit coupon)
M3_CLEAR_R = 1.7
CABLE_SLOT_ANG = 90.0                          # neck/head USB-C cable pass angle
CABLE_SLOT_R = (19.0, 26.5)
SPLINE_TOP = DV.head_floor_z                   # servo spline top ~ head floor underside
CLUTCH_POCKET_R = 16.0
UPRIGHT_REAR_X = -34.0                         # rear face of the rear upright (DV.upright_x[0])
CTRL_BACK_X = UPRIGHT_REAR_X - BD.ctrl_standoff            # board back face (touches standoffs)
CTRL_FRONT_X = CTRL_BACK_X - BD.ctrl_t                     # component (Pico) side, faces the rear
BTN_BACK_X = UPRIGHT_REAR_X - BD.btn_standoff
BTN_FRONT_X = BTN_BACK_X - 1.6
BTN_TOP_X = BTN_FRONT_X - BD.btn_h                         # button cap top (MEASURE)


def body_outer():
    return solid_of_profile(B.profile, segs=pr.segs)


def body_inner(extra=0.0, z_bottom=None):
    return solid_of_profile(B.profile, inset=pr.shell + extra,
                            z_bottom=(B.base_z - 1 if z_bottom is None else z_bottom), segs=pr.segs)


def r_out(z):
    return interp_profile(B.profile, z)


def shell_x(z, y, inner=False, sign=1):
    r = r_out(z) - (pr.shell if inner else 0.0)
    return sign * math.sqrt(max(r * r - y * y, 0.0))


# --------------------------------------------------------------------------- base
def base_plate():
    pt = DV.plate_top
    plate = cyl_z(DV.plate_r, B.base_z, pt, segs=pr.segs)
    adds, cuts = [], []
    for s in (1, -1):
        # wheel guard well (walls + roof) - keeps fingers out of the tyre/plate nip
        y_in0, y_in1 = sorted((s * WELL_IN_Y0, s * WELL_IN_Y1))
        y_o0, y_o1 = sorted((s * WELL_OUT_Y0, s * (WELL_OUT_Y0 + D.wheel_well_wall)))
        adds.append(box(-WELL_X - D.wheel_well_wall, WELL_X + D.wheel_well_wall, y_in0, y_in1, pt, WELL_TOP))
        adds.append(box(-WELL_X - D.wheel_well_wall, WELL_X + D.wheel_well_wall, y_o0, y_o1, pt, WELL_TOP))
        for sx in (1, -1):
            x0, x1 = sorted((sx * WELL_X, sx * (WELL_X + D.wheel_well_wall)))
            adds.append(box(x0, x1, min(y_in0, y_o0), max(y_in1, y_o1), pt, WELL_TOP))
        adds.append(box(-WELL_X - D.wheel_well_wall, WELL_X + D.wheel_well_wall,
                        min(y_in0, y_o0), max(y_in1, y_o1), WELL_TOP, WELL_TOP + D.wheel_well_wall))
        # shaft / hub-boss hole through guard wall
        cuts.append(cyl_y(8.0, y_in0 - 0.1, y_in1 + 0.1, 0.0, DV.axle_z))
        # wheel slot through plate
        ys = sorted((s * WELL_IN_Y1, s * WELL_OUT_Y0))
        cuts.append(box(-WELL_X, WELL_X, ys[0], ys[1], B.base_z - 1, pt + 0.1))
        # motor cradle: floor pad + inner wall
        my0, my1 = sorted((s * DV.motor_in_y, s * DV.motor_out_y))
        adds.append(box(DV.motor_x0 + 2, DV.motor_x1 - 2, my0, my1, pt, DV.motor_z0 - 0.2))
        wy0, wy1 = sorted((s * (DV.motor_in_y - 0.2), s * (DV.motor_in_y - 2.7)))
        adds.append(box(DV.motor_x0 + 2, DV.motor_x1 - 2, wy0, wy1, pt, DV.motor_z1 + 0.3))
        cuts.append(cyl_y(4.0, min(wy0, wy1) - 0.1, max(wy0, wy1) + 0.1, 0.0, DV.axle_z))  # inner shaft stub
        # strap peg holes in cradle wall top + strap tongue slots in guard wall
        for sx in (-10.0, -45.0):
            cuts.append(cyl_z(1.6, DV.motor_z1 - 6, DV.motor_z1 + 1, sx, s * (DV.motor_in_y - 1.45)))
            cuts.append(box(sx - 4.3, sx + 4.3, *sorted((s * (WELL_IN_Y0 - 0.1), s * (WELL_IN_Y0 + 1.6))),
                            DV.motor_z1 + 0.1, B.tray_z + 0.2))
    # caster towers (roof carries the swivel stem; print with support inside)
    for sx in (1, -1):
        cx = sx * C.x
        adds.append(tube_z(C.tower_r, CASTER_HOLE_R - 0.01, pt - 0.01, CASTER_ROOF_Z + 5, cx, 0))
        adds.append(cyl_z(C.tower_r, CASTER_ROOF_Z, CASTER_ROOF_Z + 5, cx, 0))
        cuts.append(cyl_z(CASTER_HOLE_R, B.base_z - 1, CASTER_ROOF_Z, cx, 0, segs=64))
        cuts.append(cyl_z(C.stem_d / 2 + pr.clearance, CASTER_ROOF_Z - 1, CASTER_ROOF_Z + 6, cx, 0))
    # columns (lower axis), tray legs: peg sockets
    for (x, y) in COLUMN_LOW:
        cuts.append(cyl_z(3.0 + pr.clearance / 2, pt - 3, pt + 0.1, x, y))
    for (x, y) in TRAY_LEGS:
        cuts.append(cyl_z(2.5 + pr.clearance / 2, pt - 3, pt + 0.1, x, y))
    # frame screws: M3 from below through the plate into each column (pan head under the plate)
    for (x, y) in COLUMN_LOW:
        cuts.append(cyl_z(M3_CLEAR_R, B.base_z - 1, pt + 0.1, x, y, segs=20))
    # shell screws: M3 from below into the shell rim bosses, head in a counterbore
    for a in SHELL_SCREW_ANG_FRONT + SHELL_SCREW_ANG_REAR:
        sx, sy = polar(SHELL_SCREW_R, a)
        cuts.append(cyl_z(M3_CLEAR_R, B.base_z - 1, pt + 0.1, sx, sy, segs=20))
        cuts.append(cyl_z(3.3, B.base_z - 1, B.base_z + 1.0, sx, sy, segs=24))
    # colour sensor (downward) window + PiicoDev peg posts; accelerometer pegs
    cuts.append(box(22 - 7, 22 + 7, -7, 7, B.base_z - 1, pt + 1))
    for (cx, cy) in ((22.0, 0.0), (-20.0, 0.0)):
        h = BD.piico_hole_pitch / 2
        for dx in (-h, h):
            for dy in (-h, h):
                adds.append(cyl_z(1.15, pt, pt + 4.0, cx + dx, cy + dy, segs=16))
                adds.append(cyl_z(2.4, pt, pt + 1.5, cx + dx, cy + dy, segs=20))
    # cable pass holes (motor leads up to Robo Pico)
    for s in (1, -1):
        cuts.append(cyl_z(5.0, B.base_z - 1, pt + 1, -66.0, s * 30.0))
    # shell locating notches at the rim
    for a in SHELL_RIB_ANGLES:
        cx, cy = polar(DV.plate_r - 1.5, a)
        cuts.append(box(-1.8, 1.8, -7.3, 7.3, B.base_z - 1, pt + 1).rotate((0, 0, a)).translate((cx, cy, 0)))
    out = union([plate] + adds) - union(cuts)
    return out ^ cyl_z(DV.plate_r, B.base_z - 1, 400, segs=pr.segs)


def motor_strap():
    """One strap (print 4). Clamps a TT motor down; itself held down by the tray."""
    y0, y1 = DV.motor_in_y - 2.7, WELL_IN_Y0 + 1.5
    x = -10.0
    s = box(x - 4, x + 4, y0, y1, DV.motor_z1 + 0.3, B.tray_z - 0.1)
    s = s + cyl_z(1.4, DV.motor_z1 - 5, DV.motor_z1 + 0.4, x, DV.motor_in_y - 1.45, segs=20)
    return s


def tray():
    """Battery tray = QW01 cradle. Side rails and front wall are sized for the LARGEST bank in
    the accommodation band; the rear (port) end is fully open, and the floor behind the port
    plane is cut away so plug overmoulds that hang below the bank are not blocked."""
    t0, t1 = B.tray_z, DV.tray_top
    shape = box(-100, 100, -47, 47, t0, t1)
    adds = []
    for s in (1, -1):
        adds.append(box(BAT.port_x, CAV_X1 + BAT.rail_t, *sorted((s * CAV_HW, s * (CAV_HW + BAT.rail_t))),
                        t1 - 0.01, t1 + BAT.rail_h))
    adds.append(box(CAV_X1, CAV_X1 + 8.0, -CAV_HW - BAT.rail_t, CAV_HW + BAT.rail_t, t1 - 0.01, t1 + BAT.rail_h))
    for (x, y) in TRAY_LEGS:
        adds.append(cyl_z(5.0, DV.plate_top + 0.2, t0 + 0.01, x, y))
        adds.append(cyl_z(2.5 - pr.clearance / 2, DV.plate_top - 2.8, DV.plate_top + 0.3, x, y))
    out = union([shape] + adds) ^ body_inner(1.2)
    cuts = []
    for (x, y) in COLUMN_LOW:
        cuts.append(cyl_z(COLUMN_R + pr.clearance + 0.2, t0 - 1, t1 + 6, x, y))
    for s in (1, -1):
        # hook-and-loop strap slots just outside the rails (2 straps)
        for sx in BAT.strap_x:
            cuts.append(box(sx - BAT.strap_w / 2, sx + BAT.strap_w / 2, *sorted((s * STRAP_SLOT_Y[0], s * STRAP_SLOT_Y[1])),
                            t0 - 1, t1 + 1))
        # upright leg sockets
        cuts.append(box(DV.upright_x[0] - 0.2, DV.upright_x[1] + 0.2, *sorted((s * 38.0, s * 46.0)), t1 - 2.0, t1 + 0.1))
        # motor/cable pass
        cuts.append(box(-62, -52, *sorted((s * 36.0, s * 46.0)), t0 - 1, t1 + 1))
    # plug relief behind the port plane (the whole end stays open; port positions unknown)
    cuts.append(box(-110, BAT.port_x, -SWEEP_Y - 1.0, SWEEP_Y + 1.0, t0 - 1, t1 + 1))
    return out - union(cuts)


def bank_shim(side=1):
    """Removable side shim (print one L, one R). Fills the rail gap left by the bank width:
    thickness = CAV_HW - 0.2 - (w/2 + fit_gap), generated from Battery.w_nom (set it to the
    measured width and rebuild). Its rear end carries a LOW corner keeper that stops the bank
    sliding back; it reaches only keeper_overlap in from the side and keeper_h up, outside the
    assumed port sweep. Trim it off if a port turns out to be closer to the edge."""
    t1 = DV.tray_top
    px, g = BAT.port_x, BAT.fit_gap
    y0, y1 = SHIM_Y
    strip = box(px - 2.3, SPACER_X[0] - 0.3, y0, y1, t1, t1 + BAT.rail_h)
    keeper = box(px - 2.3, px - g, BAT.w_nom / 2 - BAT.keeper_overlap, y1, t1, t1 + BAT.keeper_h)
    grip = box(px + 4.0, px + 14.0, y0, y1, t1 + BAT.rail_h - 0.01, t1 + BAT.rail_h + 3.0)
    out = union([strip, keeper, grip])
    return out if side > 0 else out.mirror((0, 1, 0))


def bank_front_spacer():
    """Front spacer: sets the bank's port end on the design port plane whatever its length.
    Thickness = L_max - len_nom - fit_gap - 0.2; regenerate from the measured length."""
    t1 = DV.tray_top
    x0, x1 = SPACER_X
    plate = box(x0, x1, -(CAV_HW - 0.2), CAV_HW - 0.2, t1, t1 + BAT.rail_h)
    tab = box(x0, x1, -6.0, 6.0, t1 + BAT.rail_h - 0.01, t1 + BAT.rail_h + 4.0)
    return plate + tab


def column(low=None, high=None, jog=COLUMN_JOG_Z):
    """Front structural column (print 2, lying down; the jog lies flat on the bed).
    v0.3: lower axis at COLUMN_LOW (beside the bank), upper axis at the v0.2 deck socket.
    Pegs into base and deck; M3 at both ends. low == high gives the straight v0.2 column."""
    xh, yh = high or DV.column_xy[0]
    xl, yl = low or COLUMN_LOW[0]
    r = COLUMN_R
    j0, j1 = jog
    c = cyl_z(r, DV.plate_top, j0, xl, yl, segs=40)
    c = c + Manifold.batch_hull([Manifold.sphere(r, 40).translate((xl, yl, j0)),
                                 Manifold.sphere(r, 40).translate((xh, yh, j1))])
    c = c + cyl_z(r, j1, B.top_deck_z, xh, yh, segs=40)
    c = c + cyl_z(3.0 - pr.clearance / 2, DV.plate_top - 2.8, DV.plate_top + 0.5, xl, yl)
    c = c + cyl_z(3.0 - pr.clearance / 2, B.top_deck_z - 0.5, B.top_deck_z + 3.0, xh, yh)
    # M3 pilot holes at both ends: base -> column -> deck is a screwed frame, so lifting
    # Pip by the head cannot pull the deck off the columns.
    c = c - cyl_z(M3_PILOT_R, DV.plate_top - 3.0, DV.plate_top + 10.0, xl, yl, segs=16)
    c = c - cyl_z(M3_PILOT_R, B.top_deck_z - 10.0, B.top_deck_z + 3.1, xh, yh, segs=16)
    return c


def rear_upright():
    x0, x1 = DV.upright_x
    plate = box(x0, x1, -48, 48, DV.tray_top, B.top_deck_z) ^ body_inner(1.5)
    plate = plate - box(x0 - 1, x1 + 1, -37, 37, DV.tray_top - 1, 77.0)
    adds, cuts = [], []
    # controller standoffs; the board is held by M3 screws (thread-forming) into these
    for (u, v) in _ctrl_holes():
        z = BD.ctrl_bottom_z + v
        adds.append(cyl_x(3.2, CTRL_BACK_X, x0 + 0.01, u, z))
        cuts.append(cyl_x(M3_PILOT_R, CTRL_BACK_X - 0.1, x1 + 0.1, u, z, segs=16))
    # PiicoDev Button standoffs (M2.5 thread-forming screws; hole positions MEASURE)
    for (by, bz) in (BD.btn_wake_yz, BD.btn_move_yz):
        for (du, dv) in BD.btn_holes:
            adds.append(cyl_x(2.6, BTN_BACK_X, x0 + 0.01, by + du, bz + dv))
            cuts.append(cyl_x(1.05, BTN_BACK_X - 0.1, x1 + 0.1, by + du, bz + dv, segs=16))
    # legs into tray, tabs into deck
    for s in (1, -1):
        adds.append(box(x0, x1, *sorted((s * 38.4, s * 45.6)), DV.tray_top - 1.8, DV.tray_top + 0.1))
        adds.append(box(x0, x1, *sorted((s * 10.0, s * 20.0)), B.top_deck_z - 0.1, B.top_deck_z + 3.0))
    out = union([plate] + adds) - union(cuts)
    # cable windows (PiicoDev chain, motor leads, camera USB lead)
    out = out - box(x0 - 1, x1 + 1, -14, 14, 158, 170)
    out = out - box(x0 - 1, x1 + 1, 34, 46, 150, 170) - box(x0 - 1, x1 + 1, -46, -34, 150, 170)
    return out


def _ctrl_holes():
    hy, hz = BD.ctrl_hole_dy / 2, BD.ctrl_hole_dz / 2
    vc = BD.ctrl_h / 2
    return [(-hy, vc - hz), (hy, vc - hz), (-hy, vc + hz), (hy, vc + hz)]


def top_deck():
    z0, z1 = B.top_deck_z, DV.deck_top
    deck = cyl_z(60, z0, z1, segs=pr.segs) ^ body_inner(0.6)
    adds = []
    # fixed neck sleeve with top flange
    adds.append(tube_z(N.od / 2, N.od / 2 - N.wall, z1 - 0.01, DV.neck_top - 3.0))
    adds.append(tube_z(N.od / 2 + 2.0, N.od / 2 - N.wall, DV.neck_top - 3.0, DV.neck_top))
    # servo ledges (servo hangs on its tabs)
    body_cx = -N.servo_shaft_off
    servo_bot = SPLINE_TOP - N.servo_spline_above - N.servo_h
    tab_z = servo_bot + N.servo_tab_z
    ri = N.od / 2 - N.wall
    half = N.servo_l / 2
    adds.append(box(-ri - 0.5, body_cx - half - 0.4, -6, 6, tab_z - 8, tab_z) ^ cyl_z(ri + 0.4, z1, DV.neck_top))
    adds.append(box(body_cx + half + 0.4, ri + 0.5, -6, 6, tab_z - 8, tab_z) ^ cyl_z(ri + 0.4, z1, DV.neck_top))
    # pan stop pin at the rear of the neck top
    sx, sy = polar(N.od / 2 - N.wall / 2 + 0.5, 180.0)
    adds.append(cyl_z(1.8, DV.neck_top - 0.5, DV.neck_top + 3.0, sx, sy, segs=20))
    out = union([deck] + adds) ^ (body_inner(0.6) + cyl_z(N.od / 2 + 2.01, z1 - 1, DV.neck_top + 4))
    cuts = []
    for (x, y) in DV.column_xy:
        cuts.append(cyl_z(3.0 + pr.clearance / 2, z0 - 0.1, z0 + 3.2, x, y))
        cuts.append(cyl_z(M3_CLEAR_R, z0 - 0.1, z1 + 0.1, x, y, segs=20))   # frame screw from above
    for s in (1, -1):
        cuts.append(box(DV.upright_x[0] - 0.2, DV.upright_x[1] + 0.2, *sorted((s * 9.8, s * 20.2)), z0 - 0.1, z0 + 3.2))
    # servo screw holes
    for xo in (-N.servo_tab_span / 2 + 2.3, N.servo_tab_span / 2 - 2.3):
        cuts.append(cyl_z(0.9, tab_z - 8, tab_z + 0.1, body_cx + xo, 0, segs=12))
    # servo lead + USB-C cable pass through the deck (inside the neck)
    cuts.append(_cable_slot(z0 - 1, z1 + 1))
    cuts.append(box(body_cx - 4, body_cx + 4, -3, 3, z0 - 1, z1 + 1))
    # PiicoDev cable pass to front
    cuts.append(box(5, 22, -6, 6, z0 - 1, z1 + 1))
    return out - union(cuts)


def _cable_slot(z0, z1):
    a = CABLE_SLOT_ANG
    ri, ro = CABLE_SLOT_R
    span = math.degrees(14.0 / ((ri + ro) / 2))
    return ring_sector(ri, ro, z0, z1, a - span / 2, a + span / 2)


# --------------------------------------------------------------------------- shells
def _shell_solid():
    outer = body_outer()
    inner = body_inner(0.0)
    s = outer - inner
    s = s - cyl_z(N.od / 2 + 1.5, 150, 260)
    return s


def _pad(z, y, w, h, depth, side=1):
    """Flat-backed mounting pad grown inwards from the shell at (z, y)."""
    xin = shell_x(z, y, inner=True, sign=side)
    if side > 0:
        blk = box(xin - depth, xin + 10, y - w / 2, y + w / 2, z - h / 2, z + h / 2)
    else:
        blk = box(xin - 10, xin + depth, y - w / 2, y + w / 2, z - h / 2, z + h / 2)
    return blk ^ body_outer()


def _flat_face_x(z, y, w, h, side=1):
    """Innermost X of the outer surface over a w x h patch: a pocket back-plane that
    leaves at least the requested skin everywhere over the patch."""
    xs = []
    for dy in (-w / 2, 0, w / 2):
        for dz in (-h / 2, 0, h / 2):
            xs.append(abs(shell_x(z + dz, y + dy, sign=1)))
    return side * min(xs)


def _module_pocket(z, y, size_y, size_z, skin, depth, side=1):
    xf = _flat_face_x(z, y, size_y, size_z, side)
    if side > 0:
        return box(xf - skin - depth, xf - skin, y - size_y / 2, y + size_y / 2, z - size_z / 2, z + size_z / 2)
    return box(xf + skin, xf + skin + depth, y - size_y / 2, y + size_y / 2, z - size_z / 2, z + size_z / 2)


def _through_window(z, y, wy, wz, side=1):
    x = abs(shell_x(z, y)) + 5
    if side > 0:
        return box(x - 25, x, y - wy / 2, y + wy / 2, z - wz / 2, z + wz / 2)
    return box(-x, -x + 25, y - wy / 2, y + wy / 2, z - wz / 2, z + wz / 2)


def _ribs(side):
    out = []
    for a in SHELL_RIB_ANGLES:
        if (side > 0) != (math.cos(math.radians(a)) > 0):
            continue
        r = DV.plate_r - 1.5
        cx, cy = polar(r + 1.5, a)
        rib = box(-1.5, 1.5, -7.0, 7.0, B.base_z, B.base_z + 18).rotate((0, 0, a)).translate((cx, cy, 0))
        out.append(rib ^ body_outer())
    return out


def _shell_bosses(angles):
    """Screw bosses inside the shell rim, on top of the base plate. M3 from below."""
    out, cuts = [], []
    z0, z1 = DV.plate_top + 0.2, DV.plate_top + 14.0
    for a in angles:
        sx, sy = polar(SHELL_SCREW_R, a)
        boss = cyl_z(4.2, z0, z1, sx, sy, segs=32)
        web = box(0, 12.0, -3.0, 3.0, z0, z1).rotate((0, 0, a)).translate((sx, sy, 0))
        out.append((boss + web) ^ body_outer())
        cuts.append(cyl_z(M3_PILOT_R, z0 - 0.1, z1 - 2.0, sx, sy, segs=16))
    return out, cuts


def front_shell():
    s = _shell_solid() ^ box(0.15, 200, -200, 200, 0, 400)
    pz = BD.piico + 2 * 3.0
    bosses, boss_cuts = _shell_bosses(SHELL_SCREW_ANG_FRONT)
    pads = [
        _pad(F.oled_z, 0, 36, 32, 7),
        _pad(F.touch_z, 0, 34, 34, 6),
        _pad(F.dist_z, 0, pz, pz, 6),
        _pad(F.rgb_z, F.rgb_y, pz, pz, 6),
        _pad(F.rgb_z, -F.rgb_y, pz, pz, 6),
    ]
    s = union([s] + pads + _ribs(1) + bosses)
    cuts = list(boss_cuts)
    # OLED: viewing window + glass pocket + board pocket
    gx, gz = BD.oled_glass
    ax, az = BD.oled_active
    cuts.append(_through_window(F.oled_z, 0, ax + 1.5, az + 1.5))
    cuts.append(_module_pocket(F.oled_z, 0, gx + 0.6, gz + 0.6, 1.2, 1.8))
    cuts.append(_module_pocket(F.oled_z, 0, BD.piico + 0.6, BD.piico + 0.6, 3.0, 6.0))
    # capacitive touch: thin membrane over the three pads
    cuts.append(_module_pocket(F.touch_z, 0, BD.piico + 0.6, BD.piico + 0.6, pr.touch_membrane, 8.0))
    xf = _flat_face_x(F.touch_z, 0, BD.piico, BD.piico)
    for dy in (-8.0, 0.0, 8.0):   # shallow outer target rings (MEASURE pad pitch)
        ring = cyl_x(3.5, xf - 0.3, xf + 6, dy, F.touch_z - 4) - cyl_x(2.7, xf - 1, xf + 7, dy, F.touch_z - 4)
        cuts.append(ring)
    # distance sensor: clear aperture (no cover - avoids ToF crosstalk)
    cuts.append(_through_window(F.dist_z, 0, 12, 7))
    cuts.append(_module_pocket(F.dist_z, 0, BD.piico + 0.6, BD.piico + 0.6, 2.0, 7.0))
    # RGB "cheek" diffuser (thin white skin) left; buzzer holes right
    cuts.append(_module_pocket(F.rgb_z, F.rgb_y, BD.piico + 0.6, BD.piico + 0.6, pr.led_diffuser, 7.0))
    cuts.append(_module_pocket(F.rgb_z, -F.rgb_y, BD.piico + 0.6, BD.piico + 0.6, 1.6, 7.0))
    xb = abs(shell_x(F.rgb_z, -F.rgb_y)) + 4
    for k in range(6):
        oy, oz = polar(5.0, k * 60)
        cuts.append(cyl_x(1.0, xb - 14, xb, -F.rgb_y + oy, F.rgb_z + oz, segs=12))
    cuts.append(cyl_x(1.0, xb - 14, xb, -F.rgb_y, F.rgb_z, segs=12))
    return s - union(cuts)


def rear_shell():
    s = _shell_solid() ^ box(-200, -0.15, -200, 200, 0, 400)
    bosses, boss_cuts = _shell_bosses(SHELL_SCREW_ANG_REAR)
    adds = _ribs(-1) + bosses
    # screw ledge for the bank hatch: fused to the shell above the opening, reaching down
    # behind the hatch's top band (0.3 mm gap) so the hatch closes onto it from outside
    lx0, lx1 = HATCH_LEDGE_X
    adds.append(box(lx0 + 0.3, lx1, -5.0, 5.0, HT.screw_z - 4.5, HT.z1 + pr.clearance + 0.01))
    adds.append(box(HATCH_SI_MIN - 1.5, lx1, -5.0, 5.0, HT.z1 + pr.clearance, HT.z1 + 6.0) ^ body_outer())
    # button bosses (guide the plungers)
    for (u, z) in (BD.btn_wake_yz, BD.btn_move_yz):
        xi = shell_x(z, u, inner=True, sign=-1)
        adds.append(cyl_x(8.0, xi - 1, xi + 6, u, z) ^ body_outer())
    s = union([s] + adds)
    cuts = list(boss_cuts)
    # bank service opening (closed by rear_hatch) + pilot for the hatch screw in the ledge
    cuts.append(hatch_region(pr.clearance))
    cuts.append(cyl_x(M3_PILOT_R, lx0, lx1 + 0.1, 0, HT.screw_z, segs=16))
    # rear buttons
    for (u, z) in (BD.btn_wake_yz, BD.btn_move_yz):
        cuts.append(cyl_x(PLUNGER_CAP_R + 0.35, -120, 0, u, z))
    # power switch actuator slot (actuator slides along Y by the switch travel)
    su, sv = BD.switch_uv
    cuts.append(box(-120, -60, su - SW_BAR / 2 - 0.4, su + SW_BAR / 2 + BD.switch_travel + 0.4,
                    BD.ctrl_bottom_z + sv - SW_BAR / 2 - 0.4, BD.ctrl_bottom_z + sv + SW_BAR / 2 + 0.4))
    # vents near atmospheric sensor (rear-left) and Robo Pico
    for k in range(5):
        a = 150 + k * 4.0
        cx, cy = polar(r_out(125) - 1, a)
        cuts.append(box(-4, 4, -0.9, 0.9, 112, 138).rotate((0, 0, a + 90)).translate((cx, cy, 0)))
    return s - union(cuts)


# --------------------------------------------------------------------------- rear UI
PLUNGER_CAP_R = 4.5


def _rear_inner_x(ys, zs):
    """Rear-shell inner-surface X over a Y-Z patch: (most negative, least negative)."""
    xs = [shell_x(z, y, inner=True, sign=-1) for y in ys for z in zs]
    return min(xs), max(xs)


def _span(a, b, n=9):
    return [a + (b - a) * i / (n - 1) for i in range(n)]


HATCH_SI_MIN, _HSI = _rear_inner_x(_span(-5, 5), _span(HT.screw_z - 4.5, HT.z1 + 6))
HATCH_LEDGE_X = (_HSI, _HSI + 6.3)          # ledge 6 mm thick (screw engagement)


def hatch_region(grow=0.0, x0=-130.0, x1=-60.0):
    """Rounded-rectangle hatch outline (Y-Z plane) extruded along X."""
    w, z0, z1, r = HT.y_half + grow, HT.z0 - grow, HT.z1 + grow, HT.corner_r + grow
    pts = [cyl_x(r, x0, x1, sy * (w - r), z) for sy in (1, -1) for z in (z0 + r, z1 - r)]
    return Manifold.batch_hull(pts)


def _pod(inset=0.0):
    x0, x1 = HT.pod_x + inset, -60.0
    y = HT.pod_y_half - inset
    z0, z1 = HT.pod_z[0] + inset, HT.pod_z[1] - inset
    return rounded_box((x0 + x1) / 2, 0, (z0 + z1) / 2, x1 - x0, 2 * y, z1 - z0, HT.pod_r - inset)


def rear_hatch():
    """Bank service hatch (adult, 1 x M3 x 8). A patch of the rear shell with a shallow raised
    pod that gives the bank plugs room. Two bottom tongues hook behind the shell; one screw at
    the top goes into the shell ledge. Removing it exposes the whole port end of the bank."""
    r = hatch_region()
    h = ((body_outer() + _pod()) ^ r) - body_inner(0.0) - (_pod(pr.shell) ^ hatch_region(-pr.shell))
    xo = shell_x(HT.screw_z, 0, sign=-1)
    xi = shell_x(HT.screw_z, 0, inner=True, sign=-1)
    boss = (cyl_x(6.0, xo - 3.0, xo + 1.0, 0, HT.screw_z) ^ r) - body_inner(0.0)   # overlaps the pod top (no tangent edge)
    adds = [boss]
    for s in (1, -1):
        y0, y1 = sorted((s * (HT.tongue_y - 4), s * (HT.tongue_y + 4)))
        lo, hi = _rear_inner_x(_span(abs(y0), abs(y1)), _span(HT.z0 - 5, HT.z0 + 4))
        adds.append(box(hi + 0.3, hi + 2.3, y0, y1, HT.z0 - 5.0, HT.z0 + 4.0))      # behind the shell
        adds.append(box(lo - 1.0, hi + 2.3, y0, y1, HT.z0 + 0.4, HT.z0 + 4.0))       # bridge to the rim
    h = union([h] + adds)
    h = h - cyl_x(3.3, xo - 5.0, xo - 0.4, 0, HT.screw_z, segs=24)                  # head counterbore
    h = h - cyl_x(M3_CLEAR_R, xo - 5.0, xi + 1.0, 0, HT.screw_z, segs=20)
    return h


SW_BAR = 6.0


def switch_actuator(on=True):
    """Push-rod that lets an adult's finger reach the controller board's slide switch,
    which sits ~35 mm inside the shell. Assumes the switch slides along Y (MEASURE).
    Retained between the shell slot (grip outside) and the switch knob (fork inside)."""
    su, sv = BD.switch_uv
    z = BD.ctrl_bottom_z + sv
    y = su + (0.0 if on else BD.switch_travel)
    xo = shell_x(z, y, sign=-1)
    f = CTRL_FRONT_X
    bar = box(xo - 2.0, f - 7.0, y - SW_BAR / 2, y + SW_BAR / 2, z - SW_BAR / 2, z + SW_BAR / 2)
    fork = box(f - 9.0, f - 3.5, y - SW_BAR / 2 - 2.0, y + SW_BAR / 2 + 2.0, z - SW_BAR / 2, z + SW_BAR / 2)
    fork = fork - box(f - 7.0, f, y - 1.6, y + 1.6, z - 10, z + 10)   # knob slot (MEASURE)
    grip = box(xo - 3.5, xo - 1.9, y - SW_BAR / 2 - 2.5, y + SW_BAR / 2 + 2.5, z - SW_BAR / 2 - 1.5, z + SW_BAR / 2 + 1.5)
    return union([bar, fork, grip])


def plunger(which=0):
    """Rear button plunger: cap through shell, retaining collar inside the shell (cannot be
    pulled out once the shell is fitted), rod ending 0.3 mm above the PiicoDev Button cap."""
    u, z = (BD.btn_wake_yz, BD.btn_move_yz)[which]
    xo = shell_x(z, u, sign=-1)
    xi = shell_x(z, u, inner=True, sign=-1)
    cap = cyl_x(PLUNGER_CAP_R, xo - 1.5, xi + 0.5, u, z)
    collar = cyl_x(6.5, xi + 0.5 + 6.2, xi + 0.5 + 8.2, u, z)
    rod = cyl_x(2.5, xi + 0.4, BTN_TOP_X - 0.3, u, z)
    return union([cap, collar, rod])


# --------------------------------------------------------------------------- drive & casters
def drive_wheel(side=1):
    yc = side * DV.wheel_yc
    w = D.wheel_w
    r = D.wheel_d / 2
    prof = [(0.0, -w / 2), (r - 1, -w / 2), (r, -w / 2 + 1), (r, -2.5),
            (r - D.tyre_groove_d, -1.5), (r - D.tyre_groove_d, 1.5), (r, 2.5),
            (r, w / 2 - 1), (r - 1, w / 2), (0.0, w / 2)]
    cs = CrossSection([[(a, b) for a, b in prof]])
    wheel = Manifold.revolve(cs, 96)                    # axis = Z, then rotate to Y
    # lightening/spoke holes
    for k in range(5):
        hx, hy = polar(19.0, k * 72)
        wheel = wheel - cyl_z(6.5, -w, w, hx, hy, segs=32)
    wheel = wheel - cyl_z(r - 6, -w / 2 + 3, w, segs=64) + cyl_z(9.0, -w / 2, w / 2, segs=48)
    for k in range(5):
        a = k * 72 + 36
        wheel = wheel + (box(0, r - 6.1, -2.0, 2.0, -w / 2 + 0.01, w / 2 - 3).rotate((0, 0, a)))
    # hub boss reaching through the guard wall towards the motor
    wheel = wheel + cyl_z(6.0, -w / 2 - 3.0, -w / 2 + 0.01, segs=40)
    # TT double-D bore
    rr = D.tt_shaft_d / 2 + 0.1
    bore = cyl_z(rr, -w, w, segs=32) ^ box(-(D.tt_shaft_flat / 2 + 0.1), D.tt_shaft_flat / 2 + 0.1, -rr, rr, -w, w)
    wheel = wheel - bore
    # orient: local +Z -> world outward (side*Y); boss faces motor
    if side > 0:
        wheel = wheel.rotate((-90, 0, 0))
    else:
        wheel = wheel.rotate((90, 0, 0))
    return wheel.translate((0, yc, DV.axle_z))


def caster_fork(sx=1):
    cx = sx * C.x
    wz = C.lift + C.wheel_d / 2
    yoke_z1 = CASTER_ROOF_Z - 0.5
    yoke_z0 = yoke_z1 - C.fork_t
    half = C.wheel_w / 2 + 0.8
    stem = cyl_z(C.stem_d / 2, yoke_z1 - 0.01, CASTER_ROOF_Z + 5 + 4.5, cx, 0)
    stem = stem - tube_z(C.stem_d / 2 + 1, C.stem_d / 2 - 1.0, CASTER_ROOF_Z + 5 + 0.8, CASTER_ROOF_Z + 5 + 2.4, cx, 0)
    yoke = box(cx - C.trail - 6, cx + 5, -half - C.fork_t, half + C.fork_t, yoke_z0, yoke_z1)
    arms = []
    for s in (1, -1):
        y0, y1 = sorted((s * half, s * (half + C.fork_t)))
        arm = box(cx - C.trail - 6, cx - C.trail + 6, y0, y1, wz - 6.0, yoke_z0 + 0.01)   # flat foot for printing
        arms.append(arm)
    f = union([stem, yoke] + arms)
    f = f - cyl_y(C.axle_d / 2 + 0.15, -20, 20, cx - C.trail, wz)
    return f


def caster_wheel(sx=1):
    cx = sx * C.x - C.trail
    wz = C.lift + C.wheel_d / 2
    w = cyl_y(C.wheel_d / 2, -C.wheel_w / 2, C.wheel_w / 2, cx, wz, segs=64)
    return w - cyl_y(C.axle_d / 2 + 0.25, -10, 10, cx, wz)


def caster_axle(sx=1):
    cx = sx * C.x - C.trail
    wz = C.lift + C.wheel_d / 2
    half = C.wheel_w / 2 + 0.8 + C.fork_t
    pin = cyl_y(C.axle_d / 2, -half - 0.5, half + 0.2, cx, wz, segs=24)
    head = cyl_y(C.axle_d / 2 + 1.5, -half - 2.0, -half - 0.5, cx, wz, segs=24)
    # split tip snaps through the far arm
    pin = pin - box(cx - 0.5, cx + 0.5, half - 4, half + 1, wz - 5, wz + 5)
    tip = cyl_y(C.axle_d / 2 + 0.5, half + 0.2, half + 1.4, cx, wz, segs=24) - box(cx - 0.5, cx + 0.5, half, half + 2, wz - 5, wz + 5)
    # D-flat underneath so the pin prints lying down with layers along its length
    return union([pin, head, tip]) - box(cx - 10, cx + 10, -20, 20, wz - 10, wz - C.axle_d / 2 + 0.5)


def caster_clip(sx=1):
    cx = sx * C.x
    z0 = CASTER_ROOF_Z + 5 + 0.9
    ring = tube_z(C.stem_d / 2 + 3.0, C.stem_d / 2 - 0.9, z0, z0 + 1.4, cx, 0)
    return ring - box(cx - 10, cx - C.stem_d / 2 + 1.0, -2.2, 2.2, z0 - 1, z0 + 3)


# --------------------------------------------------------------------------- head
def _head_hull(inset=0.0):
    z0 = DV.head_floor_z
    cx, cz = 0.0, z0 + H.h / 2
    rt, rb = H.r - inset, 8.0 - inset
    pts = []
    for dx in (-1, 1):
        for dy in (-1, 1):
            pts.append(Manifold.sphere(rt, 48).translate((cx + dx * (H.d / 2 - H.r), dy * (H.w / 2 - H.r), z0 + H.h - H.r)))
            # bottom spheres centred ON the floor plane -> vertical walls where the cap is cut
            pts.append(Manifold.sphere(rb, 24).translate((cx + dx * (H.d / 2 - 8.0), dy * (H.w / 2 - 8.0), z0)))
    return Manifold.batch_hull(pts)


EYE_Z = DV.head_floor_z + H.eye_z_off


HEAD_INNER_FRONT_X = H.d / 2 - pr.shell          # flat inner face of the head front
EYE_FLANGE_X = (HEAD_INNER_FRONT_X - 1.5, HEAD_INNER_FRONT_X - 0.2)
FRAME_X = (EYE_FLANGE_X[0] - 0.3 - 2.5, EYE_FLANGE_X[0] - 0.3)   # eye frame on head_base
LENS_FRONT_X = FRAME_X[0] - 0.5
CAM_Y = H.eye_y + BD.cam_lens_uv[0]
CAM_Z = EYE_Z + BD.cam_lens_uv[1]
CAM_BOARD_X = (LENS_FRONT_X - BD.cam_lens_h - BD.cam_board_t, LENS_FRONT_X - BD.cam_lens_h)
SPK_Y, SPK_Z = -H.eye_y, DV.head_floor_z + 6.0 + 1.0 + BD.spk_h / 2
SPK_X = (FRAME_X[0] - 0.2 - BD.spk_t, FRAME_X[0] - 0.2)
MIC_HOLES = [(H.eye_y + polar(2.6, k * 72)[0], EYE_Z - 26 + polar(2.6, k * 72)[1]) for k in range(5)]   # MEASURE


def cone_x(x0, x1, r0, r1, y, z, segs=48):
    """Truncated cone along +X from x0 (radius r0) to x1 (radius r1)."""
    return Manifold.cylinder(x1 - x0, r0, r1, segs).rotate((0, 90, 0)).translate((x0, y, z))


def fov_cone(half_deg, x_end=H.d / 2 + 3.0):
    """Camera field-of-view cone from the lens front (design FOV, not the lens maximum)."""
    r0 = BD.cam_lens_d / 2
    t = math.tan(math.radians(half_deg))
    return cone_x(LENS_FRONT_X + 0.05, x_end, r0 + 0.05 * t, r0 + (x_end - LENS_FRONT_X) * t, CAM_Y, CAM_Z)


def _fov_cut():
    return fov_cone(BD.cam_fov_design / 2 + 2.0, H.d / 2 + 10.0)


def _spk_grille(x0, x1, r=0.8):
    out = []
    for iy in range(-3, 4):
        for iz in range(-1, 2):
            out.append(cyl_x(r, x0, x1, SPK_Y + iy * 3.6, SPK_Z + iz * 3.6, segs=12))
    return out


def head_cap():
    z0 = DV.head_floor_z
    inner = _head_hull(pr.shell)
    inner = Manifold.batch_hull([inner, inner.translate((0, 0, -20))])   # open bottom
    cap = _head_hull() - inner
    cap = cap - box(-200, 200, -200, 200, z0 - 50, z0 + 0.0)
    cuts = []
    # eye sockets (eyes are inserted from inside; their flange stops them coming out)
    for s in (1, -1):
        cuts.append(cyl_x(H.eye_ring_od / 2 - 2.0 + pr.clearance, 0, 80, s * H.eye_y, EYE_Z, segs=64))
    # mic port cluster under the left (camera) eye  (MEASURE mic position on the camera board)
    for (my, mz) in MIC_HOLES:
        cuts.append(cyl_x(0.8, 20, 80, my, mz, segs=12))
    # speaker grille under the right eye
    cuts += _spk_grille(20, 80)
    # rear vents
    for k in range(4):
        cuts.append(box(-80, -30, -12 + k * 8, -9 + k * 8, z0 + 30, z0 + 50))
    cap = cap - union(cuts)
    # side screw bosses -> floor (2x M3 from under the head floor)
    for s in (1, -1):
        y = s * (H.w / 2 - pr.shell - 4.0)
        boss = cyl_z(3.8, z0 + 6.2, z0 + 22, 0, y) - cyl_z(M3_PILOT_R, z0 + 6.0, z0 + 20, 0, y, segs=16)
        cap = cap + (boss ^ _head_hull(0.5))
    return cap


def head_base():
    z0 = DV.head_floor_z
    floor = (_head_hull(pr.shell + pr.clearance) ^ box(-200, 200, -200, 200, z0, z0 + 6.0))
    skirt = tube_z(N.od / 2 + 2.0 + 0.5 + 3.0, N.od / 2 + 2.0 + 0.5, DV.neck_top - 11.0, z0 + 0.01)
    # snap hooks under the neck flange (4 fingers). Hidden inside the body shoulder once
    # the shells are fitted; released only by an adult with the shells off.
    hooks = tube_z(N.od / 2 + 2.6, N.od / 2 + 0.4, DV.neck_top - 6.0, DV.neck_top - 3.5)
    hb = skirt + hooks
    for k in range(4):
        hb = hb - box(-1.2, 1.2, 0, 60, DV.neck_top - 12, DV.neck_top + 0.6).rotate((0, 0, 45 + k * 90))
    base = floor + hb
    ftop = z0 + 5.9
    inside = _head_hull(pr.shell + 0.4)
    # eye frame: backs both eye flanges so the eyes cannot be pushed into the head
    frame = box(FRAME_X[0], FRAME_X[1], -46, 46, ftop, EYE_Z + 19) ^ inside
    # camera board cradle (DFR1154 class, 42 x 42 board, lens on the eye axis)
    bx0, bx1 = CAM_BOARD_X
    half = BD.cam_board / 2
    cz0 = CAM_Z - BD.cam_lens_uv[1] - half                       # board lower edge
    cradle = box(bx0 - BD.cam_back_h - 2.0, bx1 + 1.5, CAM_Y - half - 3.0, CAM_Y + half + 3.0, ftop, cz0 + 6.0)
    cradle = cradle - box(bx0 - 0.25, bx1 + 0.25, CAM_Y - half - 0.3, CAM_Y + half + 0.3, cz0 - 0.3, cz0 + 40)
    cradle = cradle - box(bx0 - BD.cam_back_h - 0.3, bx0, CAM_Y - half + 3, CAM_Y + half - 3, cz0 - 0.3, cz0 + 40)
    cradle = cradle - box(bx1, bx1 + 2.0, CAM_Y - half + 3, CAM_Y + half - 3, cz0 + 1.5, cz0 + 40)
    cradle = cradle - box(bx0 - BD.cam_back_h, bx1 + 2, CAM_Y - 7, CAM_Y + 7, z0 - 1, cz0 + 1)   # USB-C lead path (MEASURE)
    # speaker cradle: side rails + low rear lip; the frame holds the speaker's front
    sx0, sx1 = SPK_X
    rails = []
    for s in (1, -1):
        yy = SPK_Y + s * (BD.spk_l / 2 + 0.3)
        rails.append(box(sx0 - 1.2, FRAME_X[0] + 0.01, *sorted((yy, yy + s * 2.0)), ftop, SPK_Z + BD.spk_h / 2 - 3))
    rails.append(box(sx0 - 1.2, sx0 - 0.2, SPK_Y - BD.spk_l / 2 - 2.3, SPK_Y + BD.spk_l / 2 + 2.3, ftop, ftop + 6))
    base = union([base, frame, cradle] + rails)
    cuts = []
    for s in (1, -1):
        y = s * (H.w / 2 - pr.shell - 4.0)
        cuts.append(cyl_z(M3_CLEAR_R, z0 - 1, z0 + 7, 0, y, segs=16))
    cuts.append(cyl_z(CLUTCH_POCKET_R, z0 - 1, z0 + 4.0, segs=64))
    for k in range(N.clutch_teeth):
        nx, ny = polar(CLUTCH_POCKET_R, k * 360 / N.clutch_teeth + 22.5)
        cuts.append(cyl_z(1.6, z0 - 1, z0 + 4.0, nx, ny, segs=16))
    rs = N.od / 2 - N.wall / 2 + 0.5
    cuts.append(ring_sector(rs - 2.2, rs + 2.2, z0 - 1, z0 + 3.5, 180 - N.stop_deg - 3, 180 + N.stop_deg + 3))
    cuts.append(_cable_slot(z0 - 1, z0 + 7))
    # frame openings: camera FOV, right-eye lightening hole, mic and speaker sound paths
    cuts.append(_fov_cut())
    cuts.append(cyl_x(10.0, FRAME_X[0] - 1, FRAME_X[1] + 1, -H.eye_y, EYE_Z, segs=48))
    for (my, mz) in MIC_HOLES:
        cuts.append(cyl_x(1.2, FRAME_X[0] - 1, FRAME_X[1] + 1, my, mz, segs=12))
    cuts += _spk_grille(FRAME_X[0] - 1, FRAME_X[1] + 1, r=1.0)
    return base - union(cuts)


def clutch_disc():
    """Servo horn carrier. Spring tongues click into the head pocket notches and slip
    if the head is forced (protects FS90 plastic gears). TUNE clutch_arm_t by test."""
    z0 = DV.head_floor_z + 0.1
    z1 = DV.head_floor_z + 3.9
    core = cyl_z(9.5, z0, z1, segs=48)
    core = core + box(-N.horn_len / 2 - 1.2, N.horn_len / 2 + 1.2, -N.horn_w / 2 - 1.2, N.horn_w / 2 + 1.2, z0, z1)
    beams = []
    rin = 12.6
    rout = rin + N.clutch_arm_t
    for a0 in (14.5, 104.5, 194.5, 284.5):   # bumps land on notches at 67.5 + k*90
        a1 = a0 + 55.0
        beams.append(ring_sector(rin, rout, z0, z1, a0, a1))
        beams.append(ring_sector(8.0, rout, z0, z1, a0, a0 + 6))      # root spoke
        bx, by = polar(rout + 0.6, a1 - 2)
        beams.append(cyl_z(1.5, z0, z1, bx, by, segs=16))
    disc = union([core] + beams)
    disc = disc ^ cyl_z(CLUTCH_POCKET_R + 1.2, z0 - 1, z1 + 1, segs=64)
    # horn pocket (underside) + spline screw access
    horn = box(-N.horn_len / 2 - 0.2, N.horn_len / 2 + 0.2, -N.horn_w / 2 - 0.2, N.horn_w / 2 + 0.2, z0 - 1, z0 + N.horn_t)
    horn = horn + cyl_z(3.6, z0 - 1, z0 + N.horn_t + 0.6, segs=32)
    disc = disc - horn - cyl_z(1.4, z0 - 1, z1 + 1, segs=16)
    return disc


def eye(which=1):
    """Dark eye insert (print in black). Inserted from INSIDE the head cap: the visible
    plug passes through the socket and the inner flange stops it coming out; the eye
    frame on head_base stops it being pushed in. Left eye (+Y) carries the camera
    aperture, sized for the design FOV cone (validated in build.py)."""
    y = which * H.eye_y
    xo = H.d / 2
    plug_r = H.eye_ring_od / 2 - 2.0
    plug = cyl_x(plug_r, EYE_FLANGE_X[1] - 0.01, xo + 1.0, y, EYE_Z, segs=64)
    flange = cyl_x(H.eye_ring_od / 2 + 1.0, EYE_FLANGE_X[0], EYE_FLANGE_X[1], y, EYE_Z, segs=64) ^ _head_hull(pr.shell + 0.15)
    e = plug + flange
    if which > 0:
        e = e - _fov_cut()
    else:
        # glossy "pupil" ring detail + hollow back
        e = e - (cyl_x(H.eye_ring_id / 2, xo + 0.4, xo + 3, y, EYE_Z, segs=48) - cyl_x(H.eye_ring_id / 2 - 1.2, xo, xo + 3, y, EYE_Z, segs=48))
        e = e - cyl_x(plug_r - 3.0, EYE_FLANGE_X[0] - 1, xo - 1.0, y, EYE_Z, segs=48)
    return e


# --------------------------------------------------------------------------- reference (bought) parts
def ref_power_bank():
    """MINISO QW01 at its NOMINAL (user-approximate) size, port end on the port plane."""
    z0 = DV.tray_top
    L, W, T = BAT.len_nom, BAT.w_nom, BAT.t_nom
    return rounded_box(BAT.port_x + L / 2, 0, z0 + T / 2, L, W, T, BAT.corner_r)


# Keep-out envelopes for the bank-fit regression (not printed, not in the assembly).
def bank_envelope_max():
    """Largest accommodated bank (nominal + tolerance), sharp-cornered: the physical
    accommodation cavity that structure must never enter."""
    t1 = DV.tray_top
    return box(BAT.port_x, BAT.port_x + BANK_L_MAX, -BANK_W_MAX / 2, BANK_W_MAX / 2, t1, t1 + BANK_T_MAX)


def bank_plug_keepout():
    """Every assumed port position x the largest plug + its cable bend, behind the port plane."""
    return box(BAT.port_x - PLUG_LEN, BAT.port_x, -SWEEP_Y, SWEEP_Y, *SWEEP_Z)


def bank_end_face_keepout():
    """The whole port end of the largest bank, kept open end_open_depth deep (port positions are
    unknown). Only the removable corner keepers may enter it. Deeper, K2 covers the plugs."""
    t1 = DV.tray_top
    return box(BAT.port_x - BAT.end_open_depth, BAT.port_x, -BANK_W_MAX / 2, BANK_W_MAX / 2, t1, t1 + BANK_T_MAX)


def bank_access_path():
    """Straight reach from outside the body to the port sweep with the hatch removed."""
    return box(-120.0, BAT.port_x, -SWEEP_Y, SWEEP_Y, *SWEEP_Z)


def bank_cable_route():
    """Service route for the two output leads: up the robot's left (+Y) behind the upright,
    clear of the rear buttons (-Y), to the controller level and the upright cable windows."""
    a = box(-82.0, -42.0, 4.0, 34.0, SWEEP_Z[1], 114.0)
    b = box(-62.0, -40.0, 30.0, 45.0, 96.0, 150.0)
    return (a + b) ^ body_inner(3.0)


def bank_strap_band():
    """Hook-and-loop strap path under the tray and through the slots (1.5 mm band)."""
    out = []
    for sx in BAT.strap_x:
        x0, x1 = sx - BAT.strap_w / 2 + 0.5, sx + BAT.strap_w / 2 - 0.5
        out.append(box(x0, x1, -STRAP_SLOT_Y[1] + 0.3, STRAP_SLOT_Y[1] - 0.3, B.tray_z - 1.5, B.tray_z - 0.05))
        for s in (1, -1):
            out.append(box(x0, x1, *sorted((s * (STRAP_SLOT_Y[0] + 0.3), s * (STRAP_SLOT_Y[1] - 0.3))),
                           B.tray_z - 1.5, DV.tray_top + BANK_T_MAX))
    return union(out)


def legacy_v02_column():
    """v0.2 straight column at the deck-socket axis (regression reference only)."""
    return column(low=DV.column_xy[0], high=DV.column_xy[0])


def legacy_qw01_at_v02_position():
    """The QW01 nominal envelope placed where the v0.2 bank sat (rear face x=-84 on the tray):
    the collision the v0.3 layout fixes. The bank-fit check must still detect it."""
    t1 = DV.tray_top
    return box(-84.0, -84.0 + BAT.len_nom, -BAT.w_nom / 2, BAT.w_nom / 2, t1, t1 + BAT.t_nom)


def ref_tt_motor(side=1):
    y0, y1 = sorted((side * DV.motor_in_y, side * DV.motor_out_y))
    m = box(DV.motor_x0, DV.motor_x1, y0, y1, DV.motor_z0, DV.motor_z1)
    shaft = cyl_y(D.tt_shaft_d / 2, min(y0, y1) - D.tt_shaft_len, max(y0, y1) + D.tt_shaft_len, 0, DV.axle_z, segs=16)
    return m + shaft


def ref_controller():
    """Kitronik 5331-class controller board + Pico 2 WH (envelope, MEASURE)."""
    v0 = BD.ctrl_bottom_z
    board = box(CTRL_FRONT_X, CTRL_BACK_X, -BD.ctrl_w / 2, BD.ctrl_w / 2, v0, v0 + BD.ctrl_h)
    pico = box(CTRL_FRONT_X - BD.ctrl_comp_h, CTRL_FRONT_X, -25.5, 25.5, v0 + 7.0, v0 + 28.0)
    su, sv = BD.switch_uv
    knob = box(CTRL_FRONT_X - 4.0, CTRL_FRONT_X, su - 1.5, su + 1.5, v0 + sv - 1.5, v0 + sv + 1.5)
    return union([board, pico, knob])


def ref_buttons():
    """Two PiicoDev Button modules behind the rear plungers (envelope, MEASURE)."""
    out = []
    for (by, bz) in (BD.btn_wake_yz, BD.btn_move_yz):
        h = BD.piico / 2
        out.append(box(BTN_FRONT_X, BTN_BACK_X, by - h, by + h, bz - h, bz + h))
        out.append(box(BTN_FRONT_X - 5.0, BTN_FRONT_X, by - 6, by + 6, bz - 6, bz + 6))
        out.append(cyl_x(4.0, BTN_TOP_X, BTN_FRONT_X - 4.99, by, bz, segs=24))
    return union(out)


def ref_servo():
    body_cx = -N.servo_shaft_off
    bot = SPLINE_TOP - N.servo_spline_above - N.servo_h
    b = box(body_cx - N.servo_l / 2, body_cx + N.servo_l / 2, -N.servo_w / 2, N.servo_w / 2, bot, bot + N.servo_h)
    tabs = box(body_cx - N.servo_tab_span / 2, body_cx + N.servo_tab_span / 2, -N.servo_w / 2, N.servo_w / 2, bot + N.servo_tab_z, bot + N.servo_tab_z + N.servo_tab_t)
    spline = cyl_z(2.4, bot + N.servo_h, SPLINE_TOP - N.horn_t, segs=16)
    horn = box(-N.horn_len / 2, N.horn_len / 2, -N.horn_w / 2, N.horn_w / 2, SPLINE_TOP - N.horn_t + 0.05, SPLINE_TOP + 0.05)
    return union([b, tabs, spline, horn])


def ref_cam_board():
    """DFR1154-class camera/mic/amp board behind the left eye (envelope, MEASURE)."""
    bx0, bx1 = CAM_BOARD_X
    half = BD.cam_board / 2
    yc, zc = CAM_Y - BD.cam_lens_uv[0], CAM_Z - BD.cam_lens_uv[1]
    board = box(bx0, bx1, yc - half, yc + half, zc - half, zc + half)
    back = box(bx0 - BD.cam_back_h, bx0, yc - half + 3.5, yc + half - 3.5, zc - half + 3.5, zc + half - 3.5)
    lens = cyl_x(BD.cam_lens_d / 2, bx1, LENS_FRONT_X, CAM_Y, CAM_Z, segs=32)
    return union([board, back, lens])


def ref_head_speaker():
    return box(SPK_X[0], SPK_X[1], SPK_Y - BD.spk_l / 2, SPK_Y + BD.spk_l / 2, SPK_Z - BD.spk_h / 2, SPK_Z + BD.spk_h / 2)


def ref_front_modules():
    out = []
    specs = [(F.oled_z, 0, 3.0, 4.0), (F.touch_z, 0, pr.touch_membrane, 4.0), (F.dist_z, 0, 2.0, 5.0),
             (F.rgb_z, F.rgb_y, pr.led_diffuser, 4.0), (F.rgb_z, -F.rgb_y, 1.6, 6.0)]
    for z, y, skin, th in specs:
        xf = _flat_face_x(z, y, BD.piico + 0.6, BD.piico + 0.6)     # same patch as the pocket
        out.append(box(xf - skin - th, xf - skin - 0.1, y - BD.piico / 2, y + BD.piico / 2, z - BD.piico / 2, z + BD.piico / 2))
    return union(out)


def ref_base_modules():
    out = []
    for (cx, cy) in ((22.0, 0.0), (-20.0, 0.0)):
        out.append(box(cx - BD.piico / 2, cx + BD.piico / 2, cy - BD.piico / 2, cy + BD.piico / 2, DV.plate_top + 1.5, DV.plate_top + 4.5))
    return union(out)


# --------------------------------------------------------------------------- calibration
def fit_test_coupon():
    """Print FIRST (~20 min). Rows of clearance variants for the fits that matter:
    TT double-D shaft bore, column/tray peg sockets, PiicoDev peg posts, caster stem bore.
    Record which variant fits in docs/12 and update params.py."""
    plate = box(0, 70, 0, 46, 0, 4)
    adds, cuts = [], []
    for i, extra in enumerate((0.0, 0.1, 0.2, 0.3)):
        x = 9 + i * 17
        # TT shaft bore variants (bosses so the shaft can go fully in)
        adds.append(cyl_z(6.0, 4, 10, x, 10))
        rr = D.tt_shaft_d / 2 + extra
        fl = D.tt_shaft_flat / 2 + extra
        cuts.append(cyl_z(rr, -1, 11, x, 10, segs=32) ^ box(x - fl, x + fl, 10 - rr, 10 + rr, -1, 11))
        # peg sockets (column 6 mm / tray 5 mm pegs) with clearance variants
        cuts.append(cyl_z(3.0 + extra, 1.0, 5, x - 4, 24))
        cuts.append(cyl_z(2.5 + extra, 1.0, 5, x + 4, 24))
        # caster stem bore
        cuts.append(cyl_z(C.stem_d / 2 + extra, -1, 5, x, 37))
        # PiicoDev M2.5-hole peg posts: 2.0 / 2.2 / 2.4 / 2.6 mm
        adds.append(cyl_z(1.0 + i * 0.1, 4, 8, x + 6, 37, segs=16))
    # index notches 1..4 on the edge so variants can be identified
    for i in range(4):
        for k in range(i + 1):
            cuts.append(box(5 + i * 17 + k * 2.2, 6 + i * 17 + k * 2.2, -0.1, 1.2, 2.5, 4.1))
    return union([plate] + adds) - union(cuts)


def fit_test_pegs():
    """Matching pegs (6 mm column peg, 5 mm tray peg, 8 mm caster stem) to try in the coupon."""
    return union([cyl_z(3.0 - pr.clearance / 2, 0, 8, 0, 0), cyl_z(2.5 - pr.clearance / 2, 0, 8, 10, 0),
                  cyl_z(C.stem_d / 2, 0, 10, 22, 0)])
