etphli/ist-pico-project/cad/pip_robot/params.py

"""Pip companion robot - CAD v0.3 parameters (millimetres).

EVERY dimension tagged `# MEASURE` is a placeholder taken from a datasheet,
retailer listing or a typical part. It MUST be checked against the physical part
before printing anything other than fit-test coupons. See
docs/12-measurement-calibration-checklist.md.

Coordinate system (assembly): origin on the floor under the robot centre,
+X = forward (the face/screen side), +Y = robot's left, +Z = up.
"""

from dataclasses import dataclass, field

VERSION = "0.3-prototype"


@dataclass(frozen=True)
class Print:
    clearance: float = 0.30        # general sliding/fit clearance per side
    press: float = 0.10            # press-fit interference allowance per side
    wall: float = 2.4              # default PLA wall
    shell: float = 2.4             # body / head shell thickness
    touch_membrane: float = 1.0    # thinned shell over capacitive pads  # TEST
    led_diffuser: float = 0.8      # thinned white shell over RGB LEDs   # TEST
    segs: int = 96                 # circular resolution for large parts
    segs_small: int = 40


@dataclass(frozen=True)
class Body:
    base_r: float = 95.0           # base plate radius
    base_z: float = 14.0           # underside of base plate above floor (ground clearance)
    base_t: float = 4.0
    # Revolved "egg/bell" outer profile of the body shell: (z, outer radius)
    profile: tuple = (
        (14.0, 95.0), (30.0, 97.0), (60.0, 97.5), (90.0, 95.0), (120.0, 89.0),
        (145.0, 79.0), (165.0, 67.0), (178.0, 56.0), (185.0, 47.0), (189.0, 38.0),
        (191.0, 32.5),
    )
    top_deck_z: float = 180.0      # underside of top deck
    top_deck_t: float = 5.0
    tray_z: float = 46.0           # underside of battery tray (above motors)
    tray_t: float = 3.0
    shell_tab_w: float = 14.0
    shell_tab_h: float = 6.0


@dataclass(frozen=True)
class Drive:
    # Adafruit/Core ADA3777 "TT" gearmotor envelope (retailer: 70 x 22 x 18 mm)  # MEASURE
    tt_len: float = 70.0           # along X
    tt_h: float = 22.5             # along Z
    tt_t: float = 18.8             # along Y
    tt_shaft_from_end: float = 11.0   # shaft centre to gearbox end face   # MEASURE
    tt_shaft_d: float = 5.4        # TT double-D shaft across round      # MEASURE
    tt_shaft_flat: float = 3.7     # across flats                        # MEASURE
    tt_shaft_len: float = 9.0      # shaft protrusion per side            # MEASURE
    wheel_d: float = 65.0          # printed drive wheel incl. tyre
    wheel_w: float = 18.0
    tyre_groove_d: float = 3.0     # O-ring / rubber-band tyre groove depth
    track: float = 128.0           # wheel centre-to-centre (Y)
    hub_gap: float = 4.0           # wheel inner face -> motor outer face (guard wall sits between)
    wheel_well_wall: float = 2.0
    wheel_well_gap: float = 4.0    # radial gap tyre->guard


@dataclass(frozen=True)
class Caster:
    x: float = 66.0                # +/- X position of front/rear swivel casters
    wheel_d: float = 22.0
    wheel_w: float = 9.0
    axle_d: float = 5.0            # printed axle pin
    trail: float = 8.0
    stem_d: float = 8.0
    fork_t: float = 3.0
    lift: float = 1.5              # casters sit this much ABOVE the drive-wheel plane
                                   # (rocker behaviour, avoids 4-point indeterminacy)
    tower_r: float = 25.0


@dataclass(frozen=True)
class Battery:
    # Owned MINISO QW01 10 000 mAh. Size is the USER'S APPROXIMATE estimate (2026-10-20:
    # "about 13 x 6 x 1 cm"), NOT a measurement and NOT a datasheet value.       # MEASURE
    len_nom: float = 130.0         # along X   user approx
    w_nom: float = 60.0            # along Y   user approx
    t_nom: float = 10.0            # along Z   user approx
    # Accommodation band: the cradle, keep-outs and access are built for ANY bank inside
    # these fixed size ranges. Updating the nominal bank size changes the fillers, not the rails.
    len_range: tuple = (126.0, 134.0)
    w_range: tuple = (56.0, 64.0)
    t_range: tuple = (8.0, 16.0)     # thickness is the least certain ("about 1 cm")
    corner_r: float = 3.0          # edge rounding of the preview envelope only  # MEASURE
    fit_gap: float = 0.3           # bank -> shim / spacer / keeper gap
    port_x: float = -47.5          # bank port (rear) end-face plane, held there by the front spacer
    # Port positions are NOT confirmed (not even that all ports share one end). The keep-out
    # sweeps a plug envelope over every port centre inside these ASSUMED limits.
    port_y_max: float = 16.0       # |y| of any port centre                       # MEASURE
    port_edge_z: float = 3.0       # port centre at least this far inside top/bottom faces  # MEASURE
    # Plugs used in the bank end (docs/04 W1, W14; charging lead). (protrusion beyond the
    # port face, width, height, extra length for the cable/wire to bend)
    plug_out1: tuple = (40.0, 19.0, 11.4, 8.0)   # ADA3628 52 x 19 x 11.4 overall (Adafruit) minus ~12 inserted  # MEASURE
    plug_out2: tuple = (32.0, 16.0, 9.0, 12.0)   # USB-A -> USB-C cable overmould                    # MEASURE
    plug_charge: tuple = (25.0, 11.0, 7.0, 15.0)  # micro-USB charging plug (hatch off, outputs unplugged) # MEASURE
    end_open_depth: float = 25.0   # whole end face kept open this deep (any port position visible/reachable)
    # Cradle
    rail_h: float = 6.0            # side rails and front wall above the tray (< smallest thickness)
    rail_t: float = 2.4
    keeper_overlap: float = 4.0    # removable rear corner keeper reaches this far in from each side
    keeper_h: float = 3.0          # ... and this high above the tray
    strap_x: tuple = (-21.5, 40.0)  # hook-and-loop strap slot centres
    strap_w: float = 14.0          # slot length along X (for a 12-13 mm strap)


@dataclass(frozen=True)
class Hatch:
    # Rear bank-service hatch: adult-only, 1 x M3 (a lithium bank in a children's product
    # should need a tool to reach). Opening in the rear shell, outline in the Y-Z plane.
    y_half: float = 34.0
    z0: float = 40.0
    z1: float = 82.0
    corner_r: float = 6.0
    # Shallow raised pod on the hatch: the plugs in the bank end need more length than the
    # round body leaves (see the bank-fit report). Only the hatch is enlarged, not the body.
    pod_y_half: float = 31.0
    pod_z: tuple = (42.0, 72.0)
    pod_x: float = -102.0          # pod outer face (body outer at y=0, z=60 is -97.5)
    pod_r: float = 5.0
    screw_z: float = 76.5          # M3 x 8 through the hatch into a ledge on the shell
    tongue_y: float = 20.0         # bottom hook tongues at +/- this Y


@dataclass(frozen=True)
class Boards:
    # Controller: Kitronik Compact Motor Driver Board for Pico (5331, Core CE07855).
    # Kitronik datasheet: 63 x 35 mm, 11.6 mm tall, 1.6 mm PCB, M3-clearance holes.
    # Mounted vertically on the rear upright, component (Pico) side facing the rear.
    ctrl_w: float = 63.0           # along Y
    ctrl_h: float = 35.0           # along Z
    ctrl_t: float = 1.6
    ctrl_comp_h: float = 22.0      # board top side incl. Pico 2 WH in its socket   # MEASURE
    ctrl_hole_dy: float = 55.0     # hole spacing along the long edge (datasheet drawing, read as 55)  # MEASURE
    ctrl_hole_dz: float = 28.0     # hole spacing along the short edge (datasheet drawing, read as 28) # MEASURE
    ctrl_bottom_z: float = 118.0   # board lower edge height in assembly
    ctrl_standoff: float = 4.0     # rear upright face -> board back face
    switch_uv: tuple = (-20.0, 4.0)      # MEASURE on/off slide switch (u along Y from board centre, v up from lower edge)
    switch_travel: float = 3.0           # MEASURE
    # Rear buttons: two PiicoDev Button modules (Core CE08500, 25.4 x 25.4 mm, 2x M2.5)
    btn_wake_yz: tuple = (-40.0, 92.0)   # rear button A (wake / sleep), white plunger
    btn_move_yz: tuple = (-12.0, 92.0)   # rear button B (movement enable), dark plunger
    btn_h: float = 9.5                   # MEASURE board front face -> button cap top
    btn_standoff: float = 4.0
    btn_holes: tuple = ((-10.16, -10.16), (10.16, 10.16))   # MEASURE (2x M2.5 per listing; positions assumed)
    # PiicoDev modules (Core listing: 25.4 x 25.4 mm, M2.5 holes)
    piico: float = 25.4
    piico_hole_pitch: float = 20.32      # MEASURE
    oled_glass: tuple = (27.0, 19.5)     # Core CE07911 listing
    oled_active: tuple = (23.0, 11.0)    # Core CE07911 listing
    # Head camera/mic/amp board: DFRobot ESP32-S3 AI Camera DFR1154 (42 x 42 mm, Core/DFRobot listing)
    cam_board: float = 42.0
    cam_board_t: float = 1.6             # MEASURE
    cam_back_h: float = 4.0              # MEASURE components behind the board
    cam_lens_h: float = 5.0              # MEASURE lens front above the board front face
    cam_lens_d: float = 6.0              # MEASURE lens front diameter
    cam_lens_uv: tuple = (0.0, 0.0)      # MEASURE lens centre offset from board centre (Y, Z)
    cam_fov_lens: float = 160.0          # DFRobot spec (diagonal/max, wide-angle lens)
    cam_fov_design: float = 90.0         # full cone kept clear through eye; outside it is vignetted on purpose
    usb_c_overmold: tuple = (12.5, 7.0)  # MEASURE  cable plug overmold W x H
    # Head speaker on the DFR1154 MX1.25 amp output: Adafruit Mini Oval 8 ohm 1 W (ADA3923 listing 30 x 20 x 5)
    spk_l: float = 30.0
    spk_h: float = 20.0
    spk_t: float = 5.0


@dataclass(frozen=True)
class Neck:
    # Feetech FS90 (Core CE09376 listing: 22.5 x 12.1 x 22.4 mm)               # MEASURE
    servo_l: float = 22.5
    servo_w: float = 12.1
    servo_h: float = 22.4
    servo_tab_span: float = 32.5          # MEASURE  overall length across mounting tabs
    servo_tab_z: float = 15.5             # MEASURE  tab underside above servo base
    servo_tab_t: float = 2.5
    servo_shaft_off: float = 5.6          # MEASURE  spline axis offset from body centre (X)
    servo_spline_above: float = 4.0       # MEASURE  spline top above body top
    horn_len: float = 32.0                # MEASURE  double-arm horn tip-to-tip
    horn_w: float = 6.0
    horn_t: float = 2.0
    od: float = 60.0                      # fixed neck sleeve
    wall: float = 3.0
    h: float = 28.0
    stop_deg: float = 75.0                # mechanical pan stops +/-
    clutch_teeth: int = 8
    clutch_arm_t: float = 1.6             # TUNE: thicker = higher slip torque
    clutch_arm_len: float = 14.0


@dataclass(frozen=True)
class Head:
    w: float = 120.0     # Y
    d: float = 92.0      # X
    h: float = 86.0      # Z
    r: float = 28.0      # corner radius
    eye_ring_od: float = 34.0
    eye_ring_id: float = 22.0
    eye_y: float = 27.0
    eye_z_off: float = 46.0   # eye centre above head floor
    gap_above_neck: float = 1.0


@dataclass(frozen=True)
class Front:
    oled_z: float = 122.0
    touch_z: float = 92.0
    dist_z: float = 160.0
    rgb_z: float = 160.0
    rgb_y: float = 30.0


@dataclass(frozen=True)
class Params:
    pr: Print = field(default_factory=Print)
    body: Body = field(default_factory=Body)
    drive: Drive = field(default_factory=Drive)
    caster: Caster = field(default_factory=Caster)
    bat: Battery = field(default_factory=Battery)
    hatch: Hatch = field(default_factory=Hatch)
    boards: Boards = field(default_factory=Boards)
    neck: Neck = field(default_factory=Neck)
    head: Head = field(default_factory=Head)
    front: Front = field(default_factory=Front)


P = Params()

# Rough masses (g) used ONLY for the static tip-angle estimate in build.py.
# Sources: ADA3777 listing 30.6 g; others are estimates -> weigh real parts.
COMPONENT_MASS_G = {
    "power_bank": (None, "UNMEASURED (QW01) - excluded; weigh it"),
    "tt_motor_L": (30.6, "Core ADA3777 listing"),
    "tt_motor_R": (30.6, "Core ADA3777 listing"),
    "fs90_servo": (9.0, "estimate (9 g class)"),
    "controller_with_pico": (35.0, "estimate"),
    "piicodev_buttons_x2": (10.0, "estimate"),
    "camera_board": (20.0, "estimate"),
    "head_speaker": (1.4, "ADA3923 listing"),
    "piicodev_modules_x6": (24.0, "estimate"),
    "cables": (40.0, "estimate"),
}
PLA_DENSITY = 1.24          # g/cm3
EFFECTIVE_FILL = 0.55       # walls+infill fraction for estimate only
