etphli/ist-pico-project/(commit log)

2026-10-19 Add Pip robot concept documentation and parametric CAD
    [assembly_preview.stl, base_plate.stl, bom.csv, caster_axle_F.stl, caster_clip_F.stl, caster_fork_F.stl, caster_wheel_F.stl, charge_door.stl]
2026-10-19 Revise Pip prototype sourcing, power review and mechanical retention
    [assembly_preview.stl, base_plate.stl, bom.csv, column_L.stl, eye_left_camera.stl, eye_right.stl, front_shell.stl, head_base.stl]
2026-10-19 Record owned MINISO QW01 specifications and fit constraints
    [bom.csv]
2026-10-21 Adapt Pip v0.3 to the owned MINISO QW01 power bank
    [assembly_preview.stl, bank_front_spacer.stl, bank_shim_L.stl, bank_shim_R.stl, base_plate.stl, bom.csv, charge_door.stl, column_L.stl]
2026-10-21 Add illustrated assembly guide, section viewer and sharper CAD previews
    [bom.csv]
2026-10-21 Add detailed wiring guide and editable assembly illustrations
    [bom.csv]
